amantunes/KNoT/results/pdf/14bits.pdf

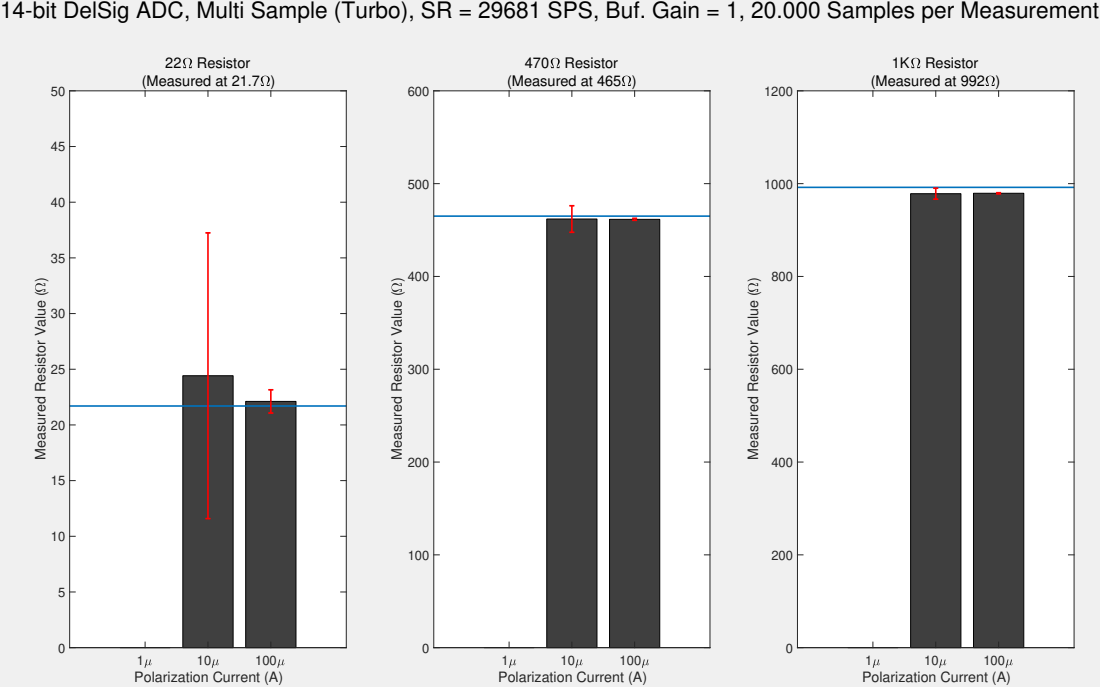
[picture p2: page 1]
22 Resistor (Measured at 21.7 ); Polarization Current (A); 470 Resistor (Measured at 465 ); 1K Resistor (Measured at 992 )

14-bit DelSig ADC, Multi Sample (Turbo), SR = 29681 SPS, Buf. Gain = 1, 20.000 Samples per Measurement

Measured Resistor Value ( )

99.7% Noise = 384.9061 V, RMS Noise = 64.151 V (1.0264 LSB) Pol. Current = 10 A , Resistor Value = 22

0 | 62 | 125 | 187 | 250 | 312 | 375 | 437 | 500 | 562
Measured Voltage ( V)

1000

2000

3000

4000

5000

6000

7000

8000

Number of Samples

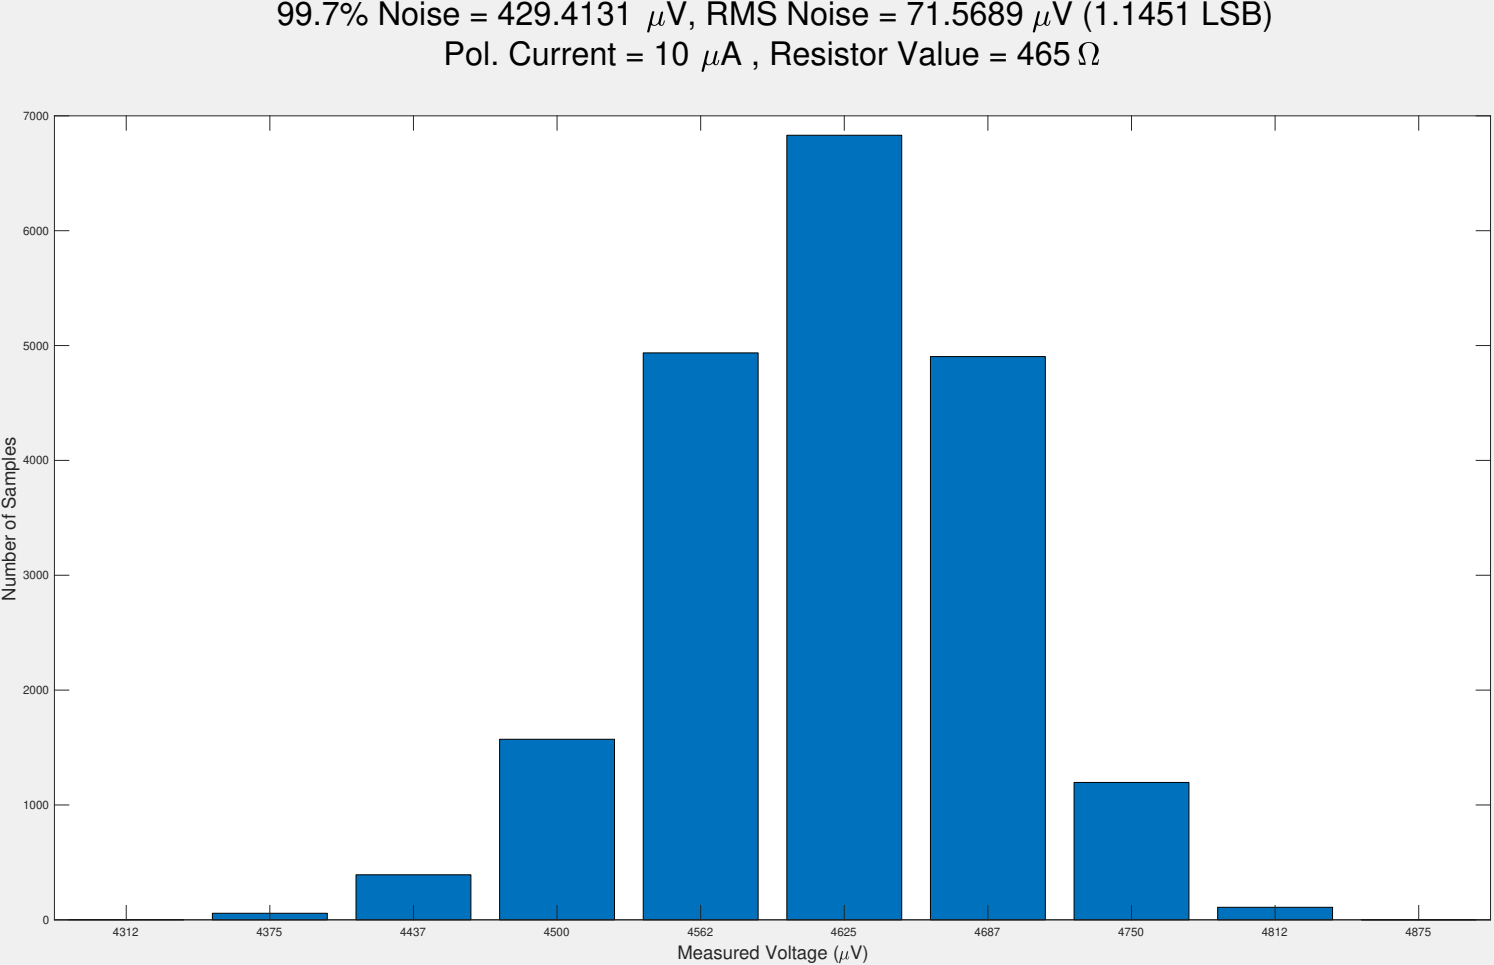
[picture p3: page 3]

99.7% Noise = 429.4131 V, RMS Noise = 71.5689 V (1.1451 LSB)

Number of Samples

99.7% Noise = 354.8669 V, RMS Noise = 59.1445 V (0.94631 LSB)

9500 | 9562 | 9625 | 9687 | 9750 | 9812 | 9875 | 9937 | 10000

1000

2000

3000

4000

5000

6000

7000

8000

9000

Number of Samples

99.7% Noise = 313.4129 V, RMS Noise = 52.2355 V (0.83577 LSB) Pol. Current = 100 A , Resistor Value = 22

2063 | 2125 | 2188 | 2250 | 2313 | 2375 | 2438

1000

2000

3000

4000

5000

6000

7000

8000

9000

Number of Samples

99.7% Noise = 318.9523 V, RMS Noise = 53.1587 V (0.85054 LSB)

45938 | 46000 | 46063 | 46125 | 46188 | 46250 | 46313 | 46375

1000

2000

3000

4000

5000

6000

7000

8000

9000

Number of Samples

99.7% Noise = 365.5644 V, RMS Noise = 60.9274 V (0.97484 LSB)

97688 | 97750 | 97813 | 97875 | 97938 | 98000 | 98063 | 98125 | 98188

1000

2000

3000

4000

5000

6000

7000

8000

9000

Number of Samples
