amantunes/KNoT/schematic/iot_sensor_node_schematic.pdf

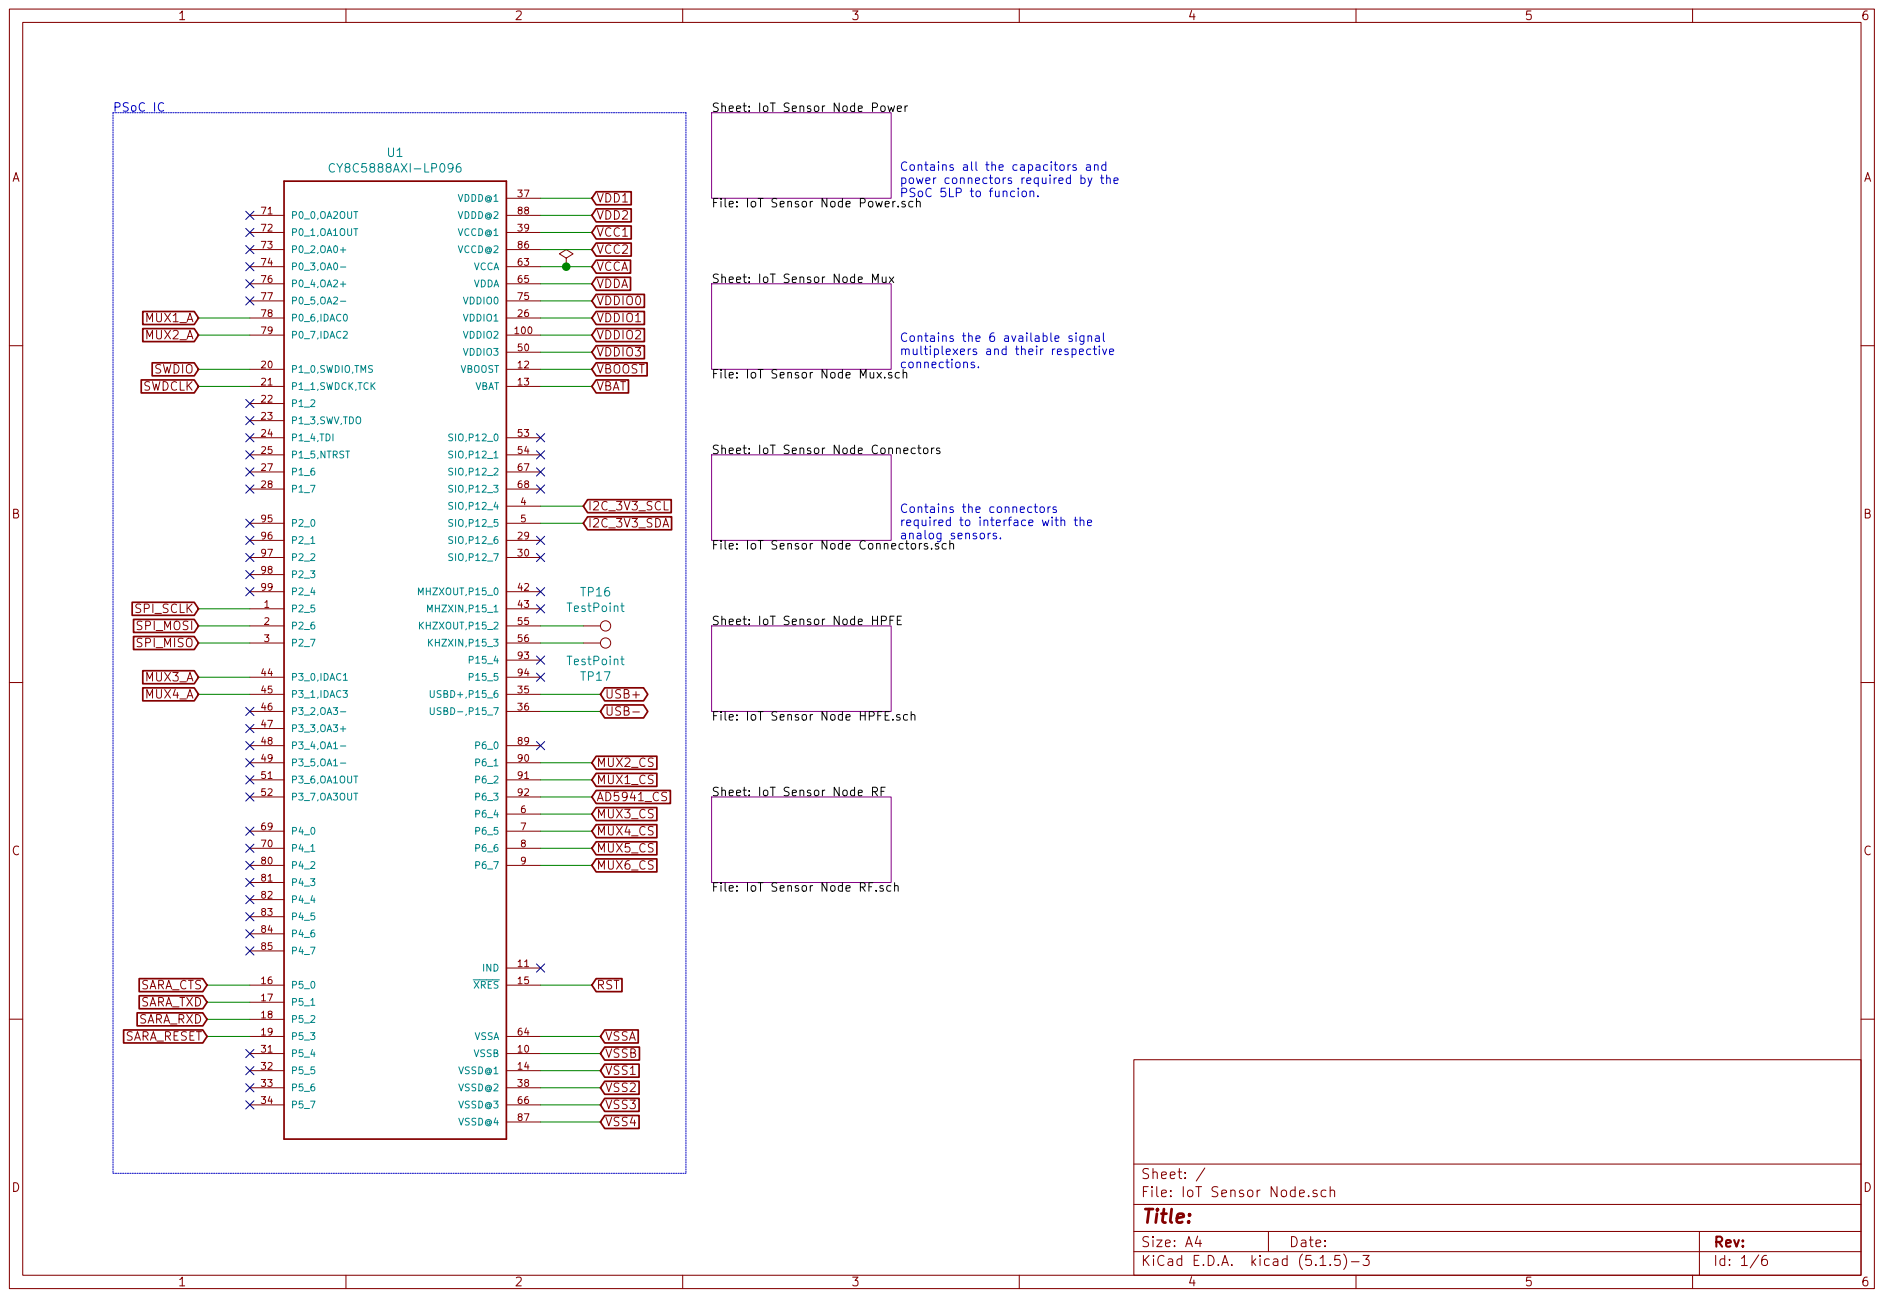
[picture p4: page 1]

File: IoT Sensor Node RF.sch Sheet: IoT Sensor Node Connectors File: IoT Sensor Node Connectors.sch Sheet: IoT Sensor Node Mux File: IoT Sensor Node Mux.sch Sheet: IoT Sensor Node Power File: IoT Sensor Node Power.sch TP17 TestPoint TP16
SARA_RESET SARA_CTS MUX1_A
I2C_3V3_SCL VDDIO2 VDDIO3 MUX3_A MUX4_A

analog sensors. PSoC IC

Contains all the capacitors and
power connectors required by the PSoC 5LP to funcion. Contains the 6 available signal

multiplexers and their respective
connections. Contains the connectors required to interface with the

Sheet: IoT Sensor Node HPFE

File: IoT Sensor Node HPFE.sch Sheet: IoT Sensor Node RF

Id: 1/6 Title: File: IoT Sensor Node.sch Sheet: /

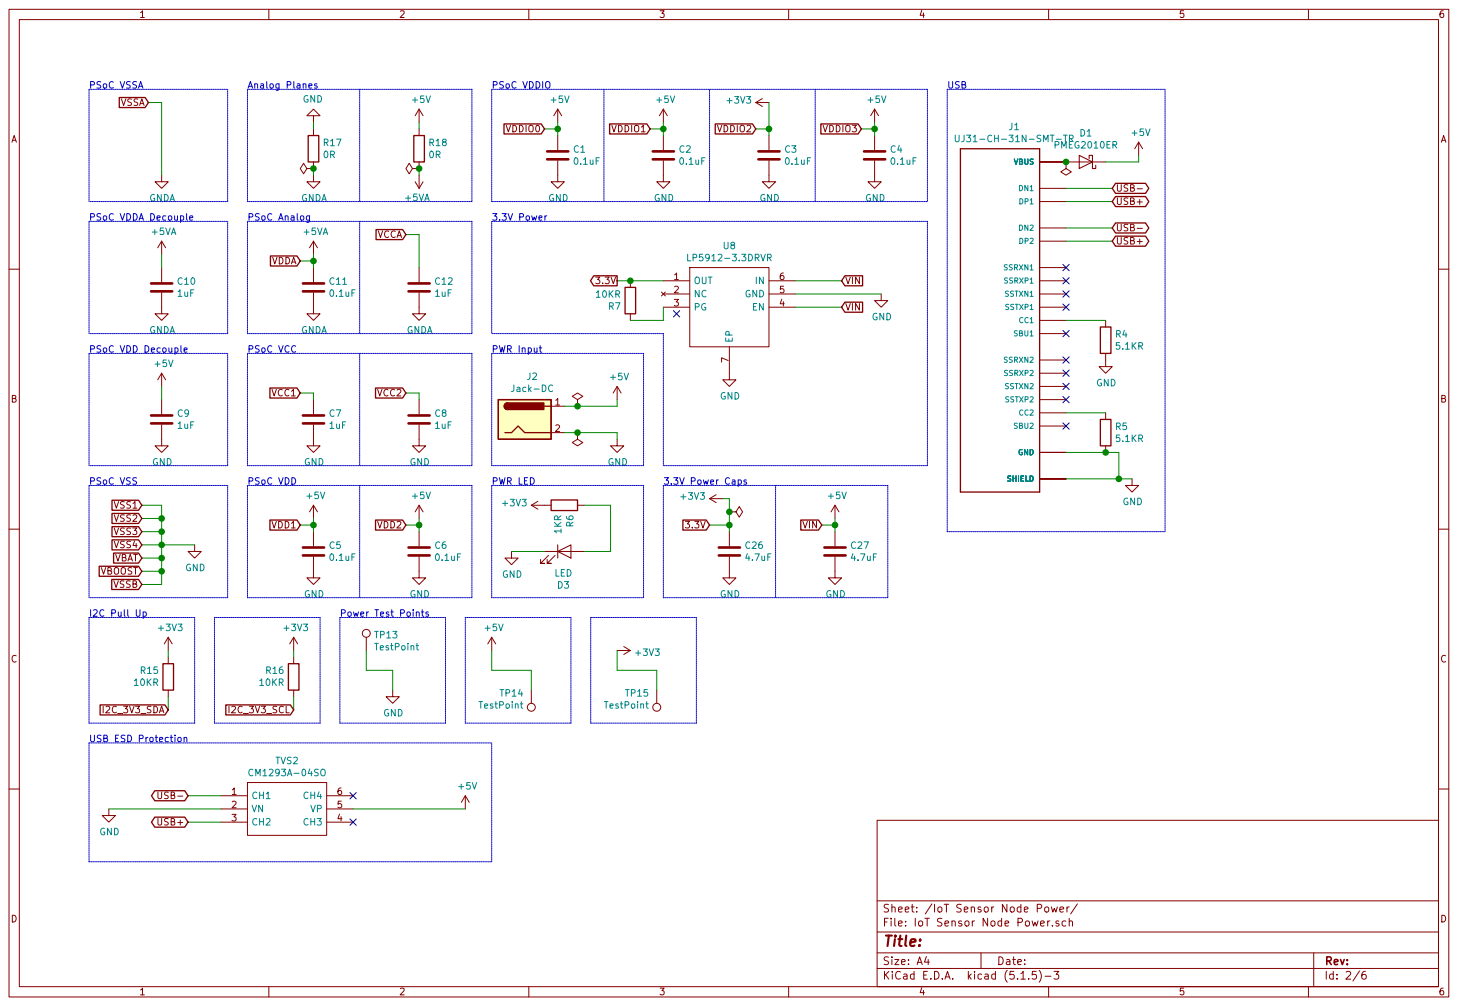
[picture p5: page 2]

PWR Input Power Test Points PSoC VDD Decouple

Id: 2/6 Title: File: IoT Sensor Node Power.sch Sheet: /IoT Sensor Node Power/

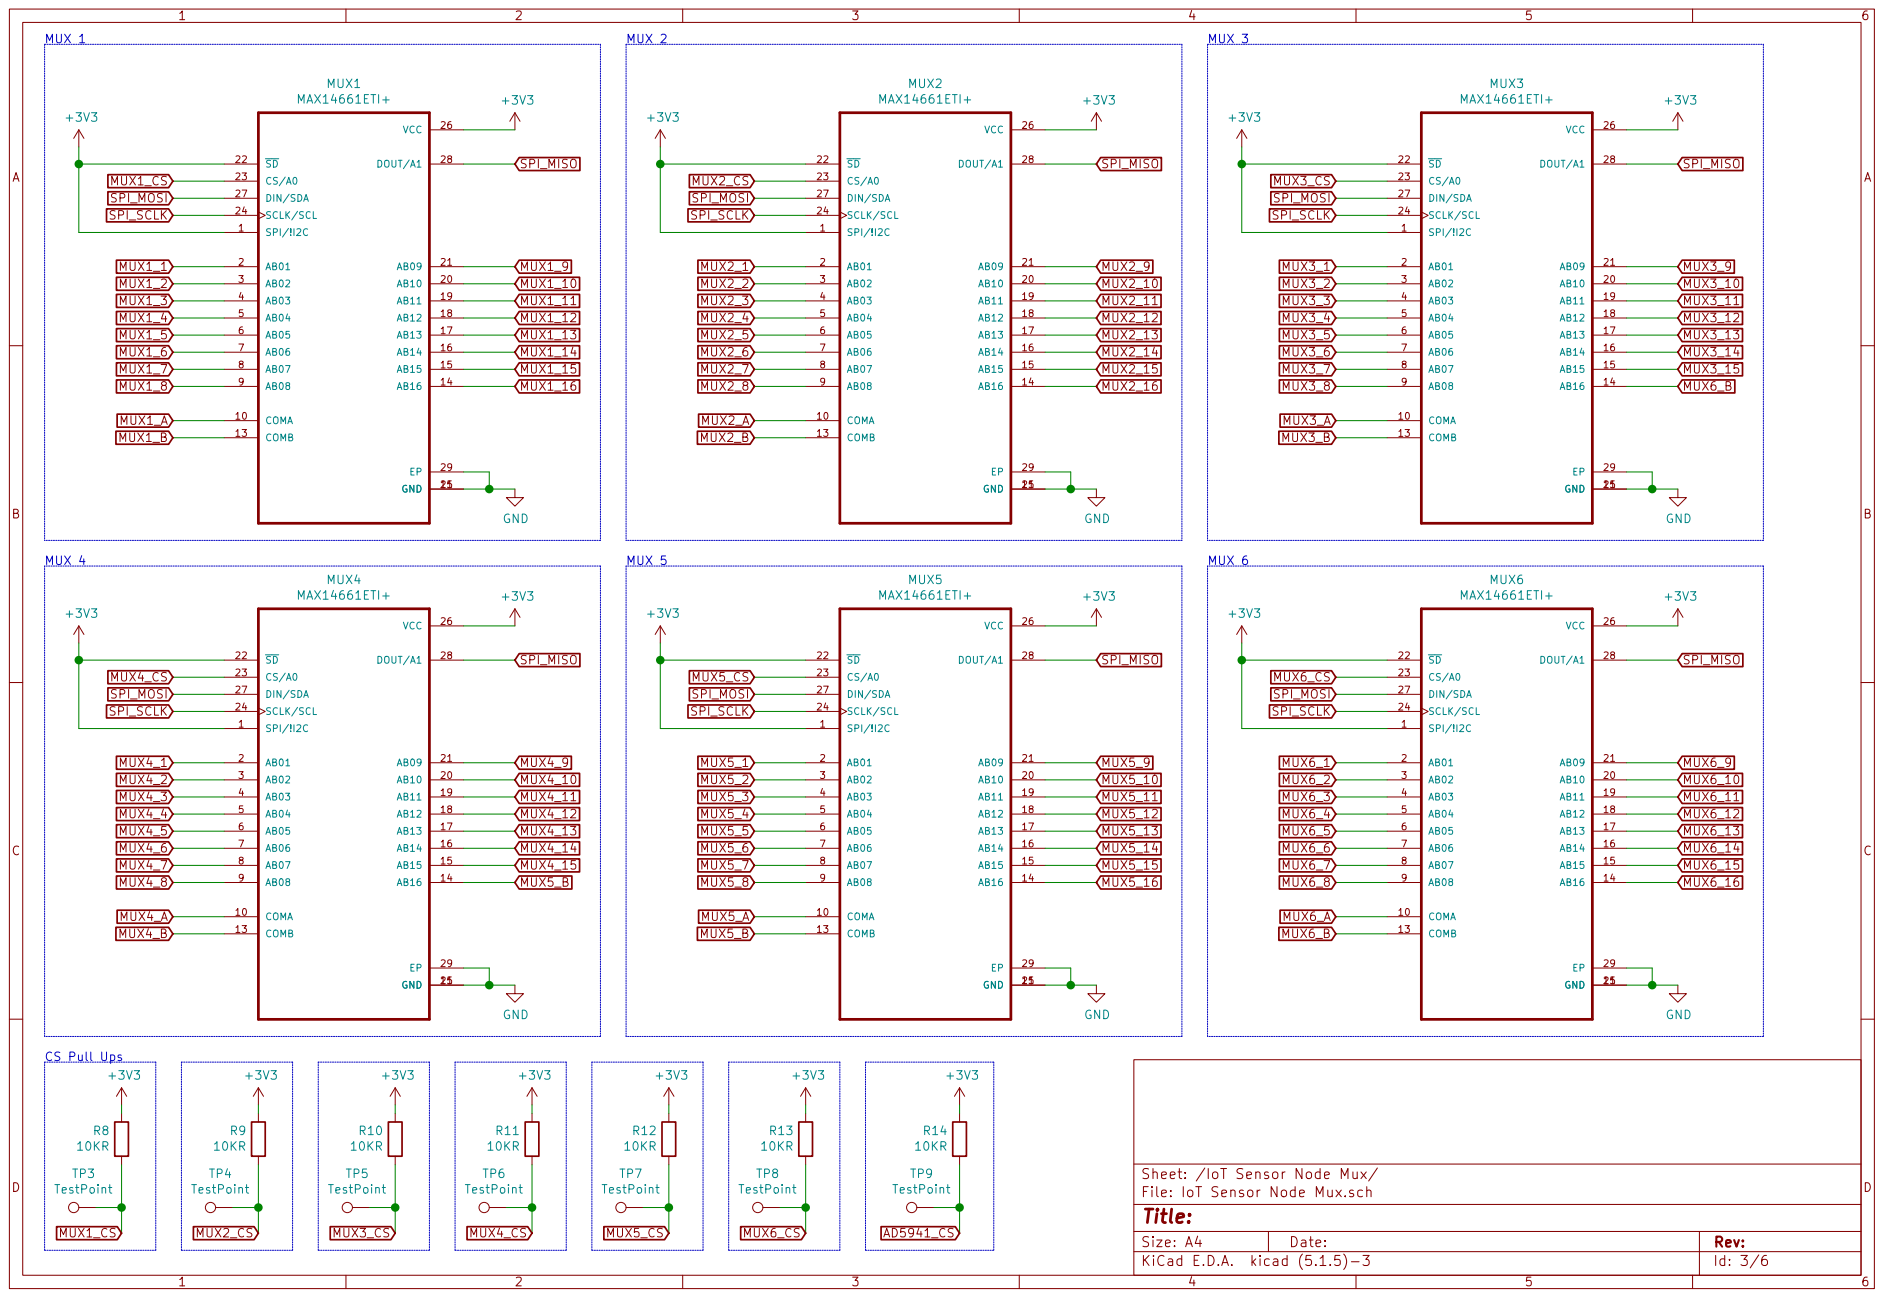
[picture p6: page 3]

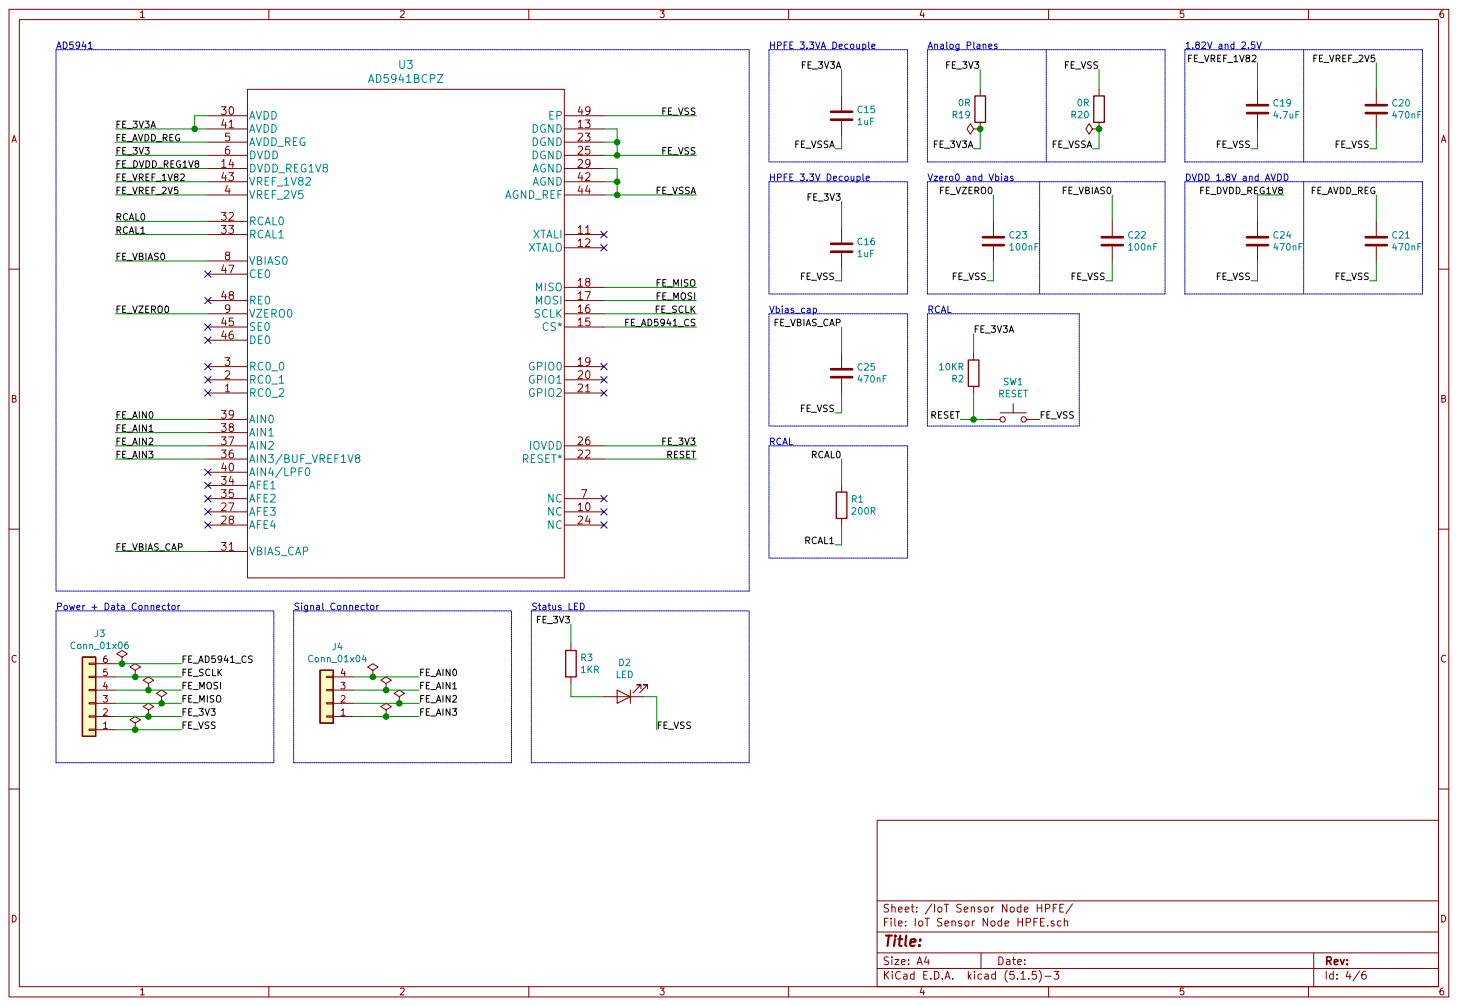
[picture p7: page 4]

Id: 4/6 Title: File: IoT Sensor Node HPFE.sch Sheet: /IoT Sensor Node HPFE/

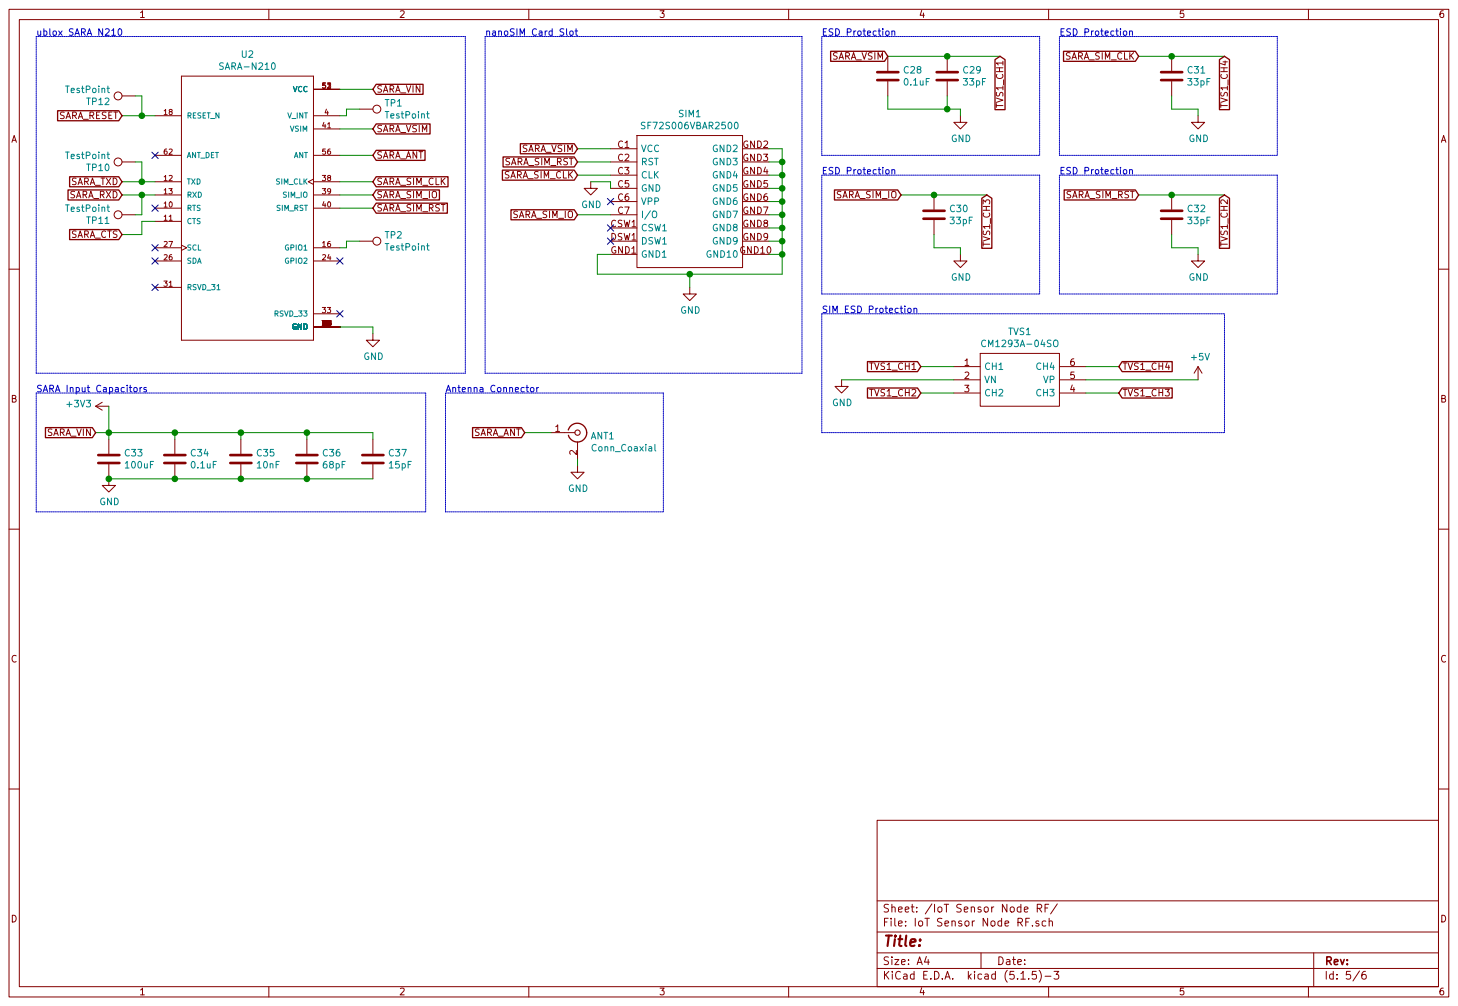
[picture p8: page 5]

Id: 5/6 Title: File: IoT Sensor Node RF.sch Sheet: /IoT Sensor Node RF/

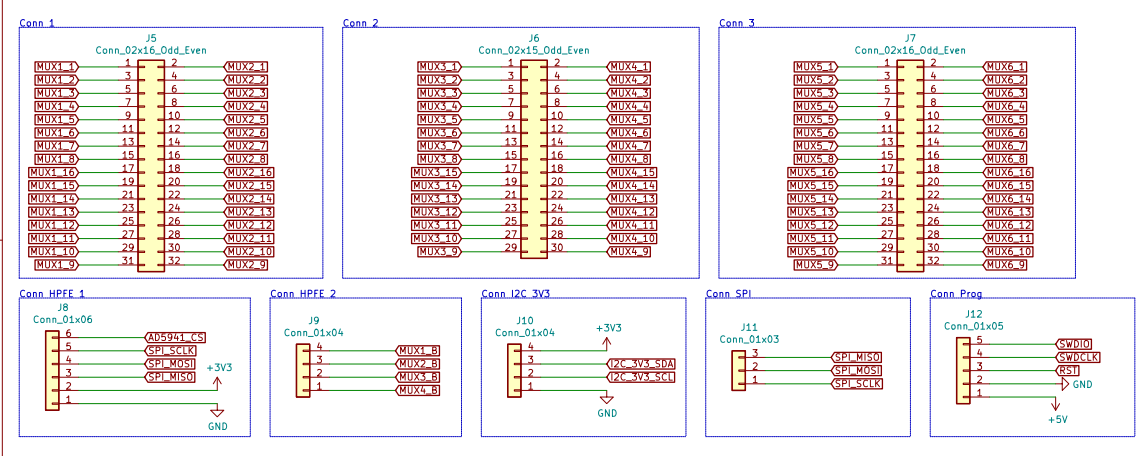
[picture p9: page 6]

Id: 6/6 Title: File: IoT Sensor Node Connectors.sch Sheet: /IoT Sensor Node Connectors/
