amantunes/KNoT/results/pdf/16bits.pdf

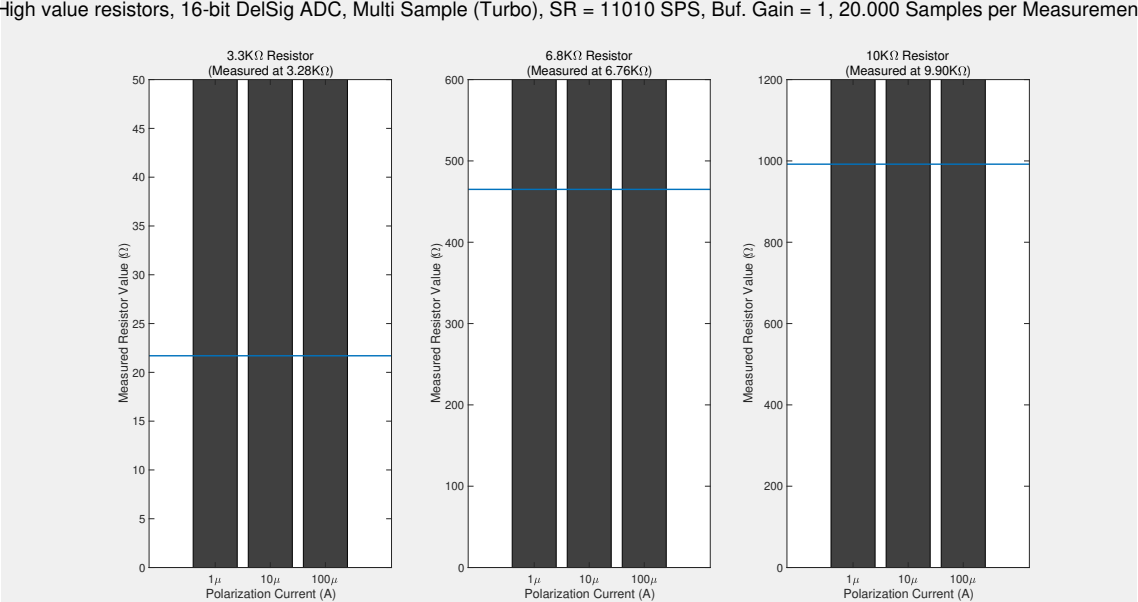
[picture p10: page 1]
3.3K Resistor (Measured at 3.28K ); Polarization Current (A); 6.8K Resistor (Measured at 6.76K ); 10K Resistor (Measured at 9.90K )

High value resistors, 16-bit DelSig ADC, Multi Sample (Turbo), SR = 11010 SPS, Buf. Gain = 1, 20.000 Samples per Measurement

Measured Resistor Value ( )

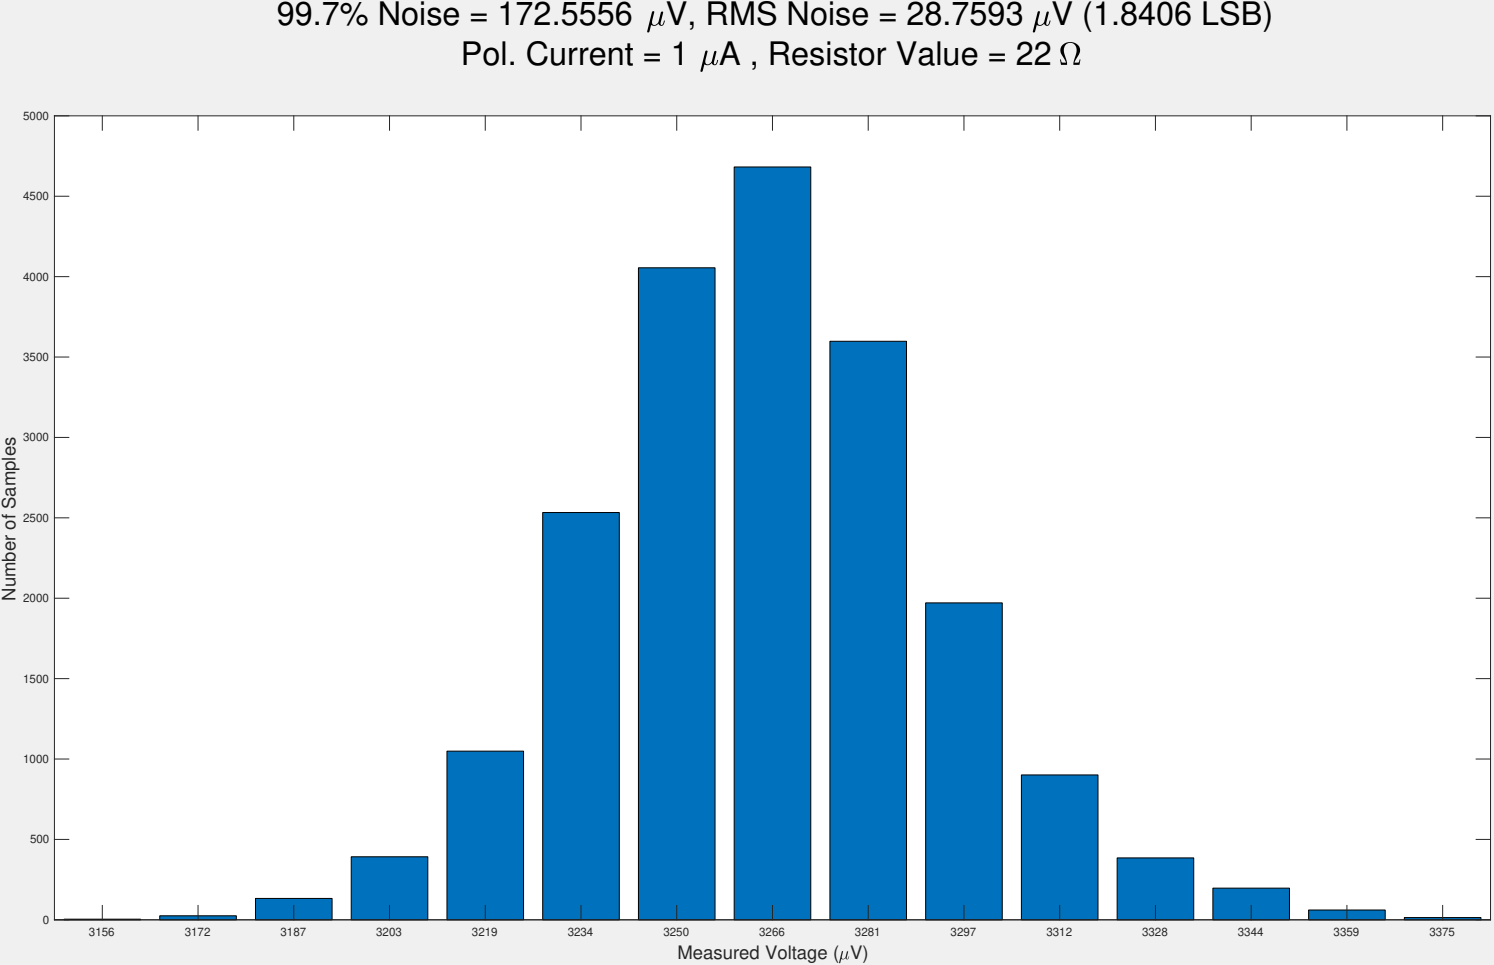
[picture p11: page 2]
Measured Voltage ( V)

99.7% Noise = 172.5556 V, RMS Noise = 28.7593 V (1.8406 LSB)

Pol. Current = 1 A , Resistor Value = 22

Number of Samples

99.7% Noise = 181.9757 V, RMS Noise = 30.3293 V (1.9411 LSB) Pol. Current = 1 A , Resistor Value = 465

6516 | 6531 | 6547 | 6562 | 6578 | 6594 | 6609 | 6625 | 6641 | 6656 | 6672 | 6687 | 6703 | 6719 | 6734 | 6750 | 6766

500

1000

1500

2000

2500

3000

3500

4000

4500

Number of Samples

99.7% Noise = 204.0454 V, RMS Noise = 34.0076 V (2.1765 LSB) Pol. Current = 1 A , Resistor Value = 992

9594 | 9609 | 9625 | 9641 | 9656 | 9672 | 9687 | 9703 | 9719 | 9734 | 9750 | 9766 | 9781 | 9797 | 9812 | 9828 | 9844

500

1000

1500

2000

2500

3000

3500

4000

Number of Samples

99.7% Noise = 169.8142 V, RMS Noise = 28.3024 V (1.8114 LSB) Pol. Current = 10 A , Resistor Value = 22

32750 | 32766 | 32782 | 32797 | 32813 | 32828 | 32844 | 32860 | 32875 | 32891 | 32907 | 32922 | 32938 | 32953 | 32969 | 32985

500

1000

1500

2000

2500

3000

3500

4000

4500

5000

Number of Samples

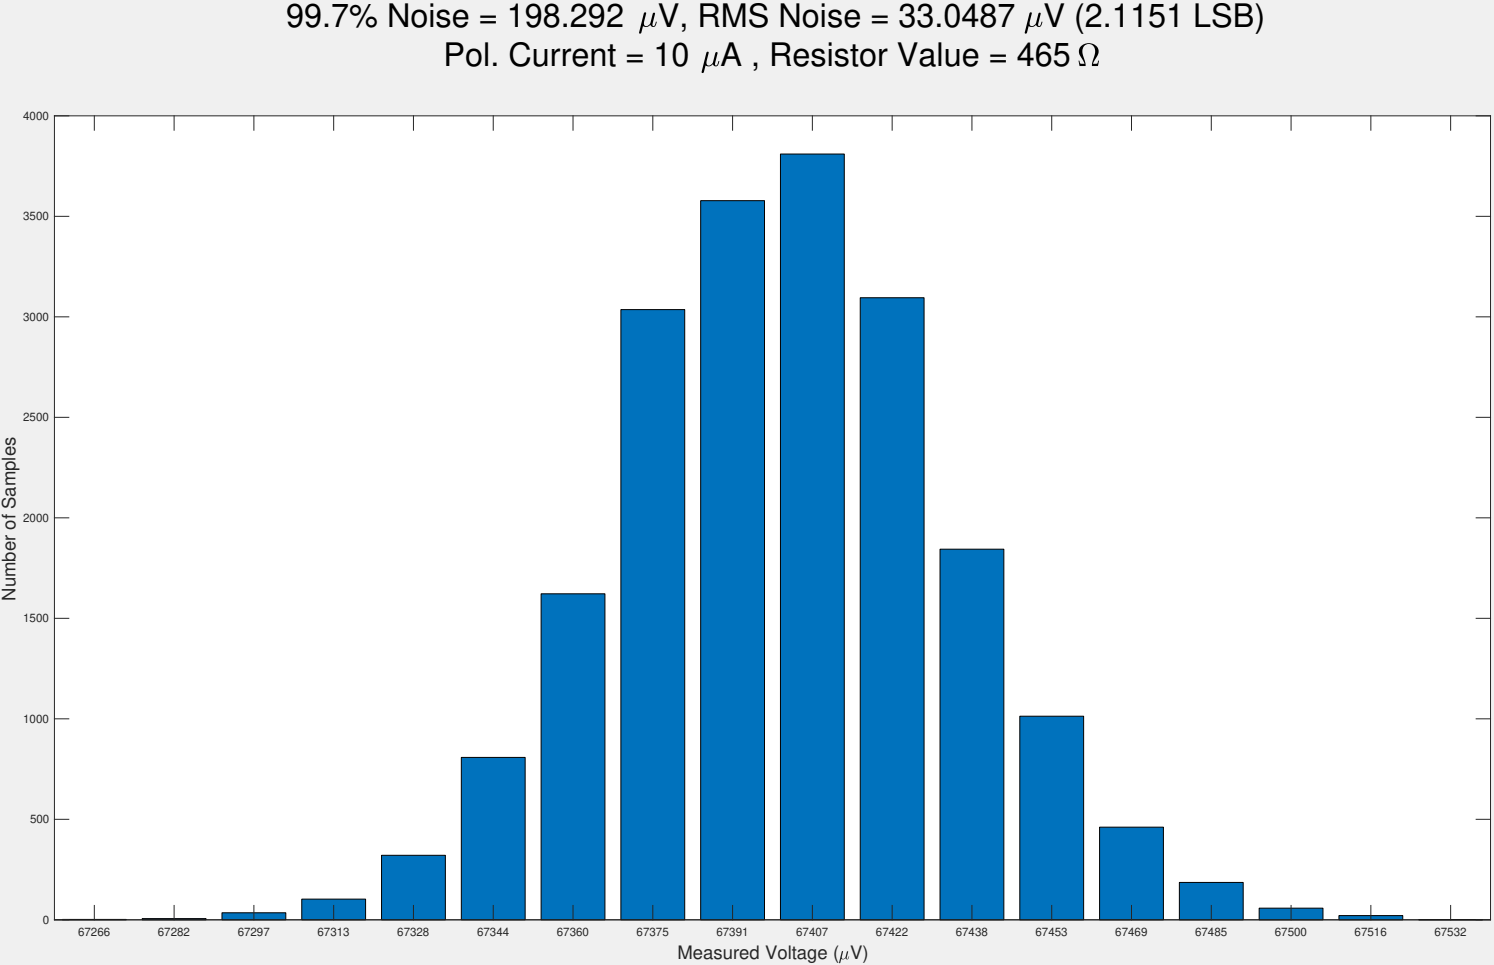
[picture p12: page 6]

99.7% Noise = 198.292 V, RMS Noise = 33.0487 V (2.1151 LSB)

Pol. Current = 10 A , Resistor Value = 465

Number of Samples
