amantunes/KNoT/results/pdf/18bits.pdf

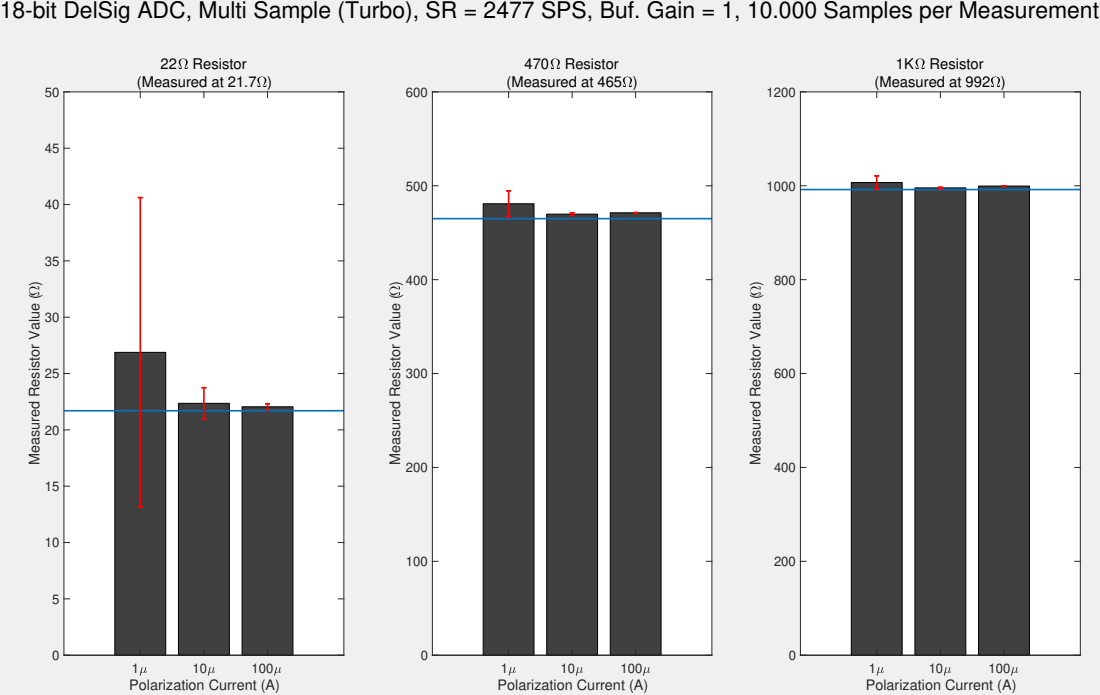
[picture p13: page 1]
22 Resistor (Measured at 21.7 ); Polarization Current (A); 470 Resistor (Measured at 465 ); 1K Resistor (Measured at 992 )

18-bit DelSig ADC, Multi Sample (Turbo), SR = 2477 SPS, Buf. Gain = 1, 10.000 Samples per Measurement

Measured Resistor Value ( )

99.7% Noise = 41.2071 V, RMS Noise = 6.8679 V (1.7582 LSB) Pol. Current = 1 A , Resistor Value = 22

0 | 4 | 8 | 12 | 15 | 19 | 23 | 27 | 31 | 35 | 39 | 43 | 47 | 51 | 54
Measured Voltage ( V)

0

500

1000

1500

2000

2500

Number of Samples

99.7% Noise = 41.3857 V, RMS Noise = 6.8976 V (1.7658 LSB) Pol. Current = 1 A , Resistor Value = 465

453 | 461 | 465 | 469 | 472 | 476 | 480 | 484 | 488 | 492 | 496 | 500 | 504 | 508 | 512

500

1000

1500

2000

2500

Number of Samples

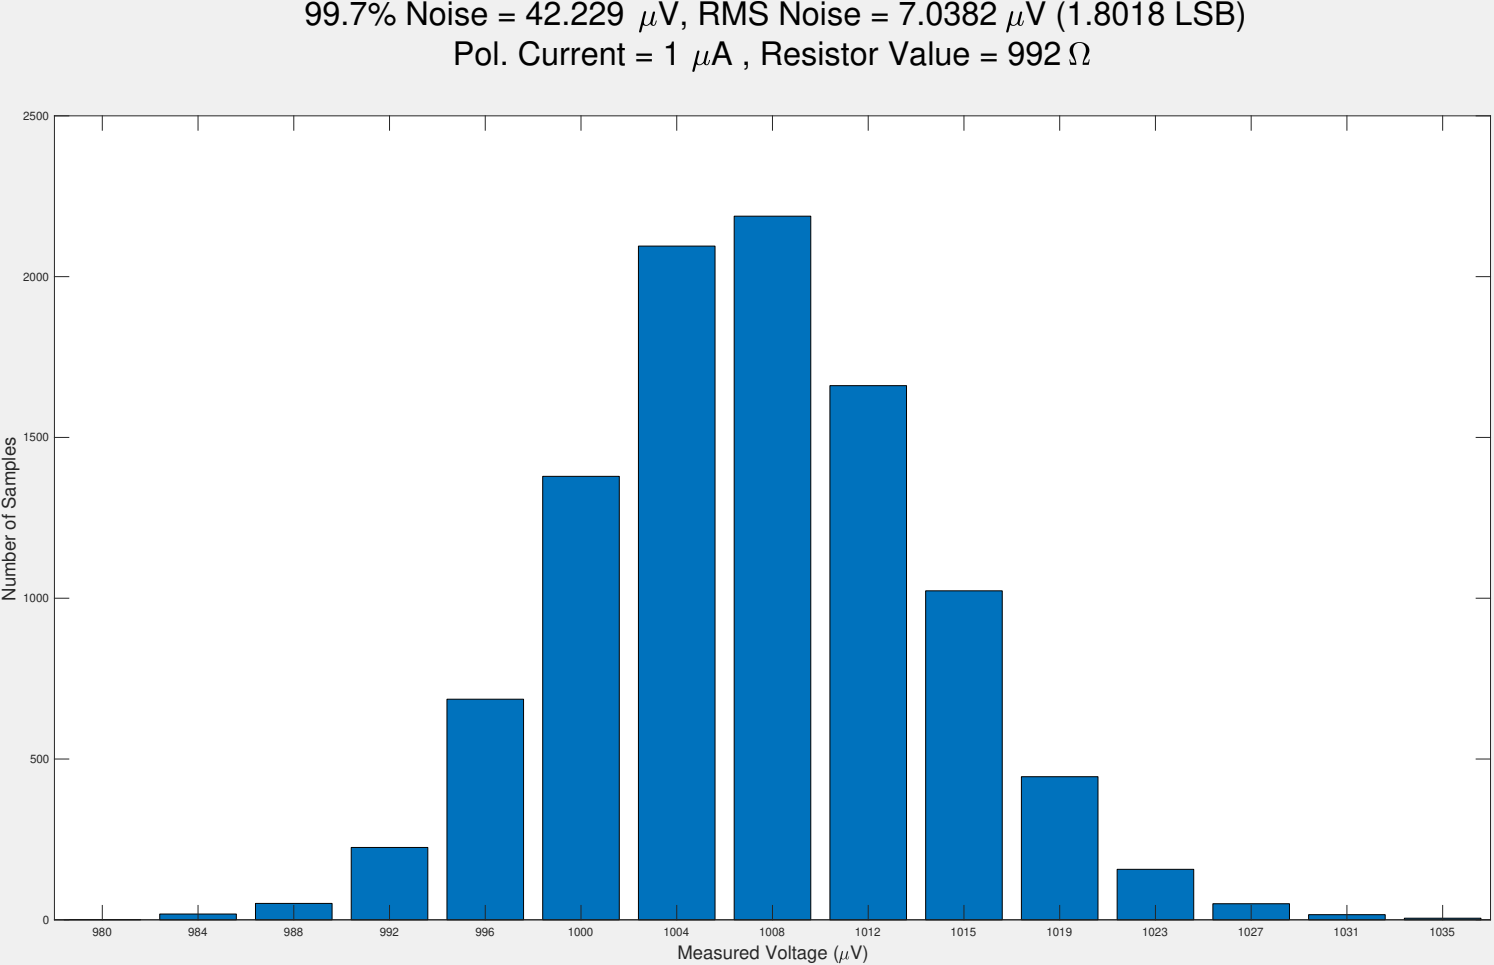
[picture p14: page 4]

99.7% Noise = 42.229 V, RMS Noise = 7.0382 V (1.8018 LSB)

Pol. Current = 1 A , Resistor Value = 992

Number of Samples

99.7% Noise = 41.5204 V, RMS Noise = 6.9201 V (1.7715 LSB) Pol. Current = 10 A , Resistor Value = 22

199 | 203 | 207 | 210 | 214 | 218 | 222 | 226 | 230 | 234 | 238 | 242 | 246 | 250

500

1000

1500

2000

2500

Number of Samples

99.7% Noise = 43.0999 V, RMS Noise = 7.1833 V (1.8389 LSB) Pol. Current = 10 A , Resistor Value = 465

4675 | 4679 | 4683 | 4687 | 4691 | 4695 | 4699 | 4703 | 4707 | 4710 | 4714 | 4718 | 4722 | 4726 | 4734

500

1000

1500

2000

2500

Number of Samples

99.7% Noise = 43.2501 V, RMS Noise = 7.2083 V (1.8453 LSB) Pol. Current = 10 A , Resistor Value = 992

9929 | 9933 | 9937 | 9941 | 9945 | 9949 | 9953 | 9957 | 9960 | 9964 | 9968 | 9972 | 9976 | 9980

500

1000

1500

2000

2500

Number of Samples

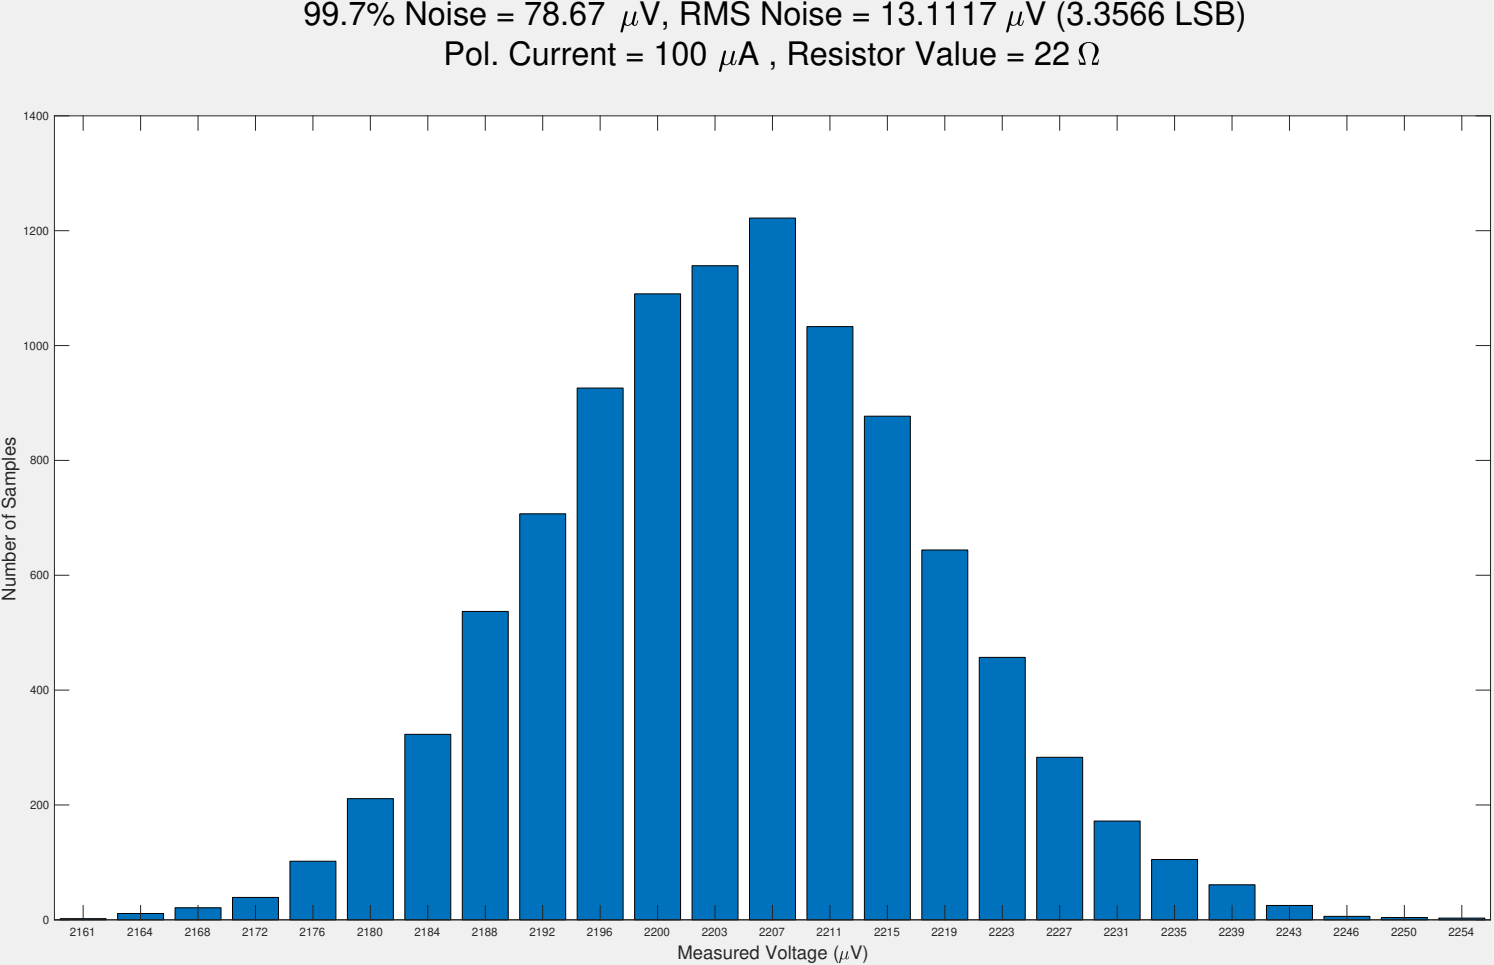
[picture p15: page 8]

99.7% Noise = 78.67 V, RMS Noise = 13.1117 V (3.3566 LSB)

Pol. Current = 100 A , Resistor Value = 22

Number of Samples

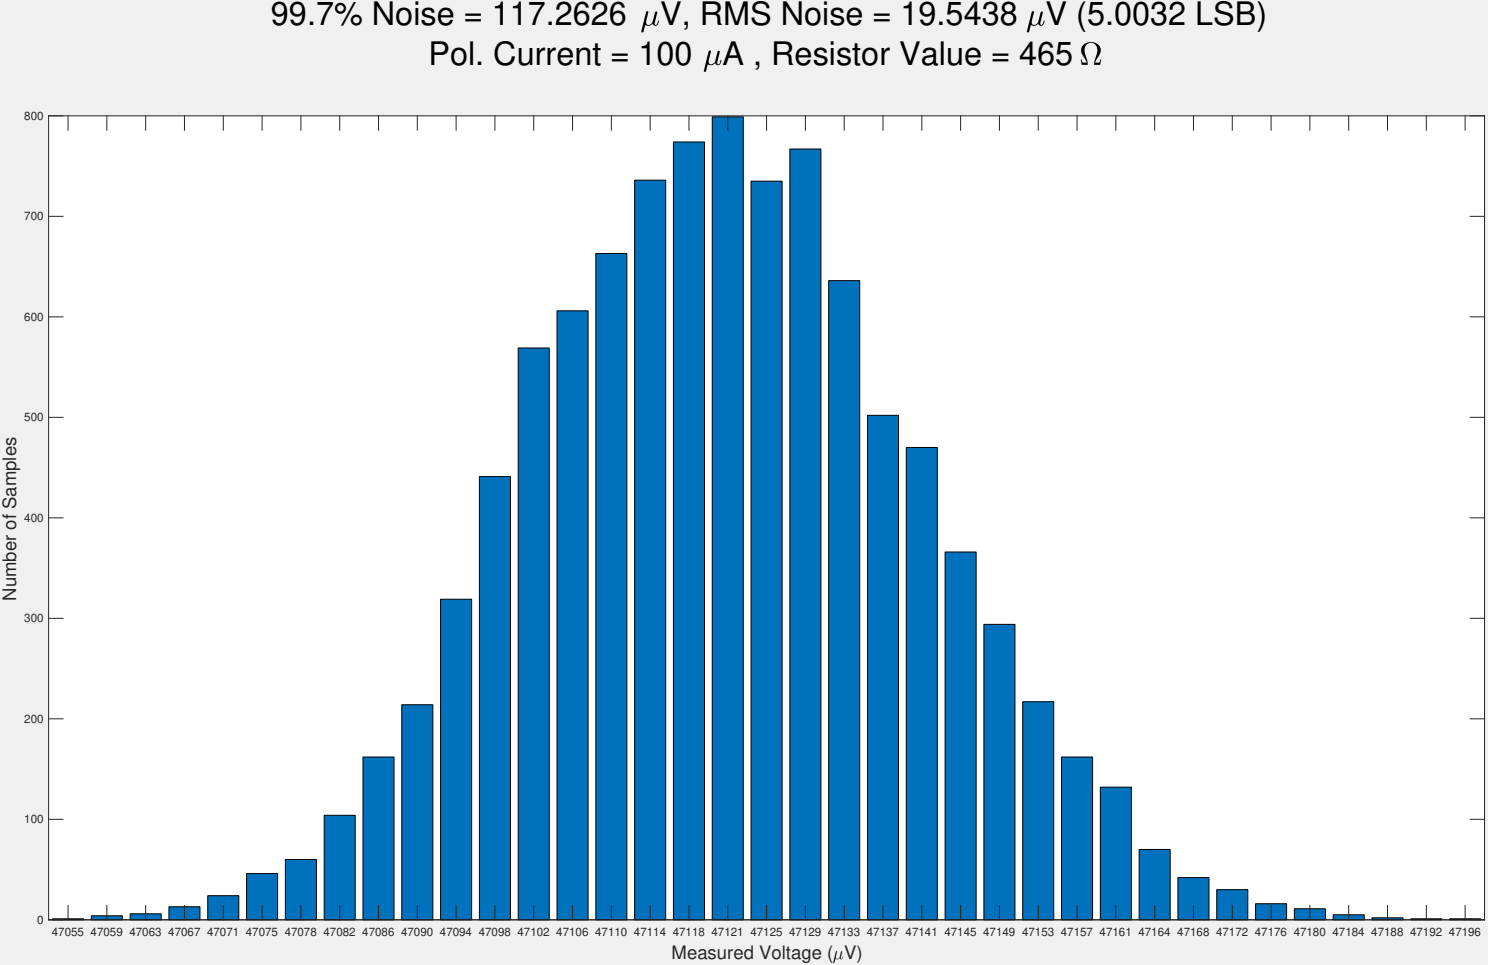
[picture p16: page 9]

99.7% Noise = 117.2626 V, RMS Noise = 19.5438 V (5.0032 LSB)

Pol. Current = 100 A , Resistor Value = 465

Number of Samples

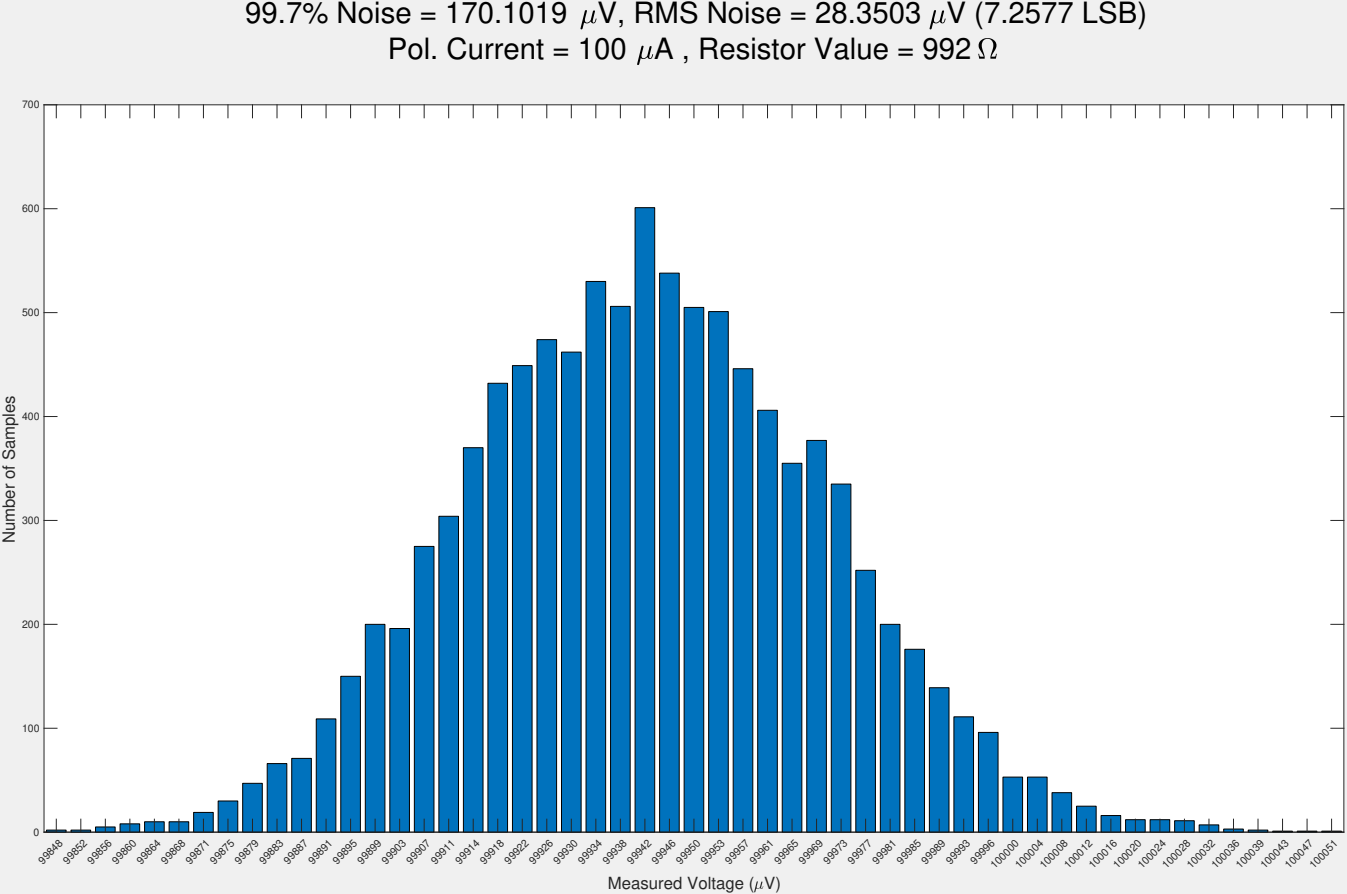
[picture p17: page 10]

99.7% Noise = 170.1019 V, RMS Noise = 28.3503 V (7.2577 LSB)

Pol. Current = 100 A , Resistor Value = 992

Number of Samples
