amantunes/KNoT/results/pdf/20bits.pdf

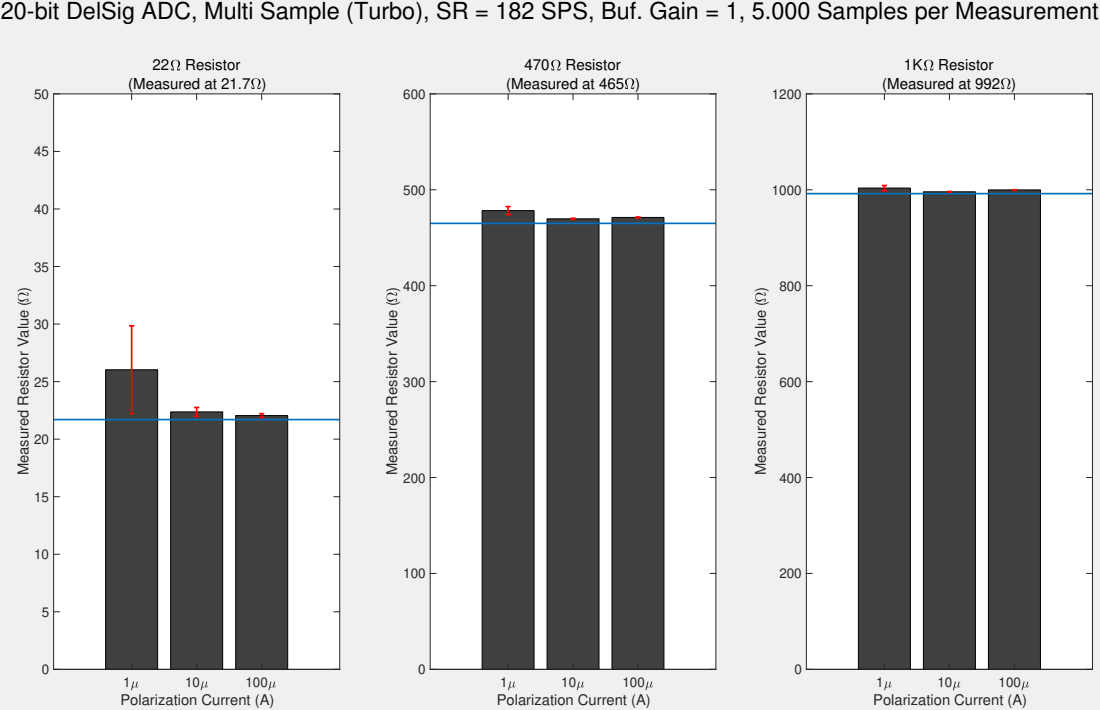
[picture p18: page 1]
22 Resistor (Measured at 21.7 ); Polarization Current (A); 470 Resistor (Measured at 465 ); 1K Resistor (Measured at 992 )

20-bit DelSig ADC, Multi Sample (Turbo), SR = 182 SPS, Buf. Gain = 1, 5.000 Samples per Measurement

Measured Resistor Value ( )

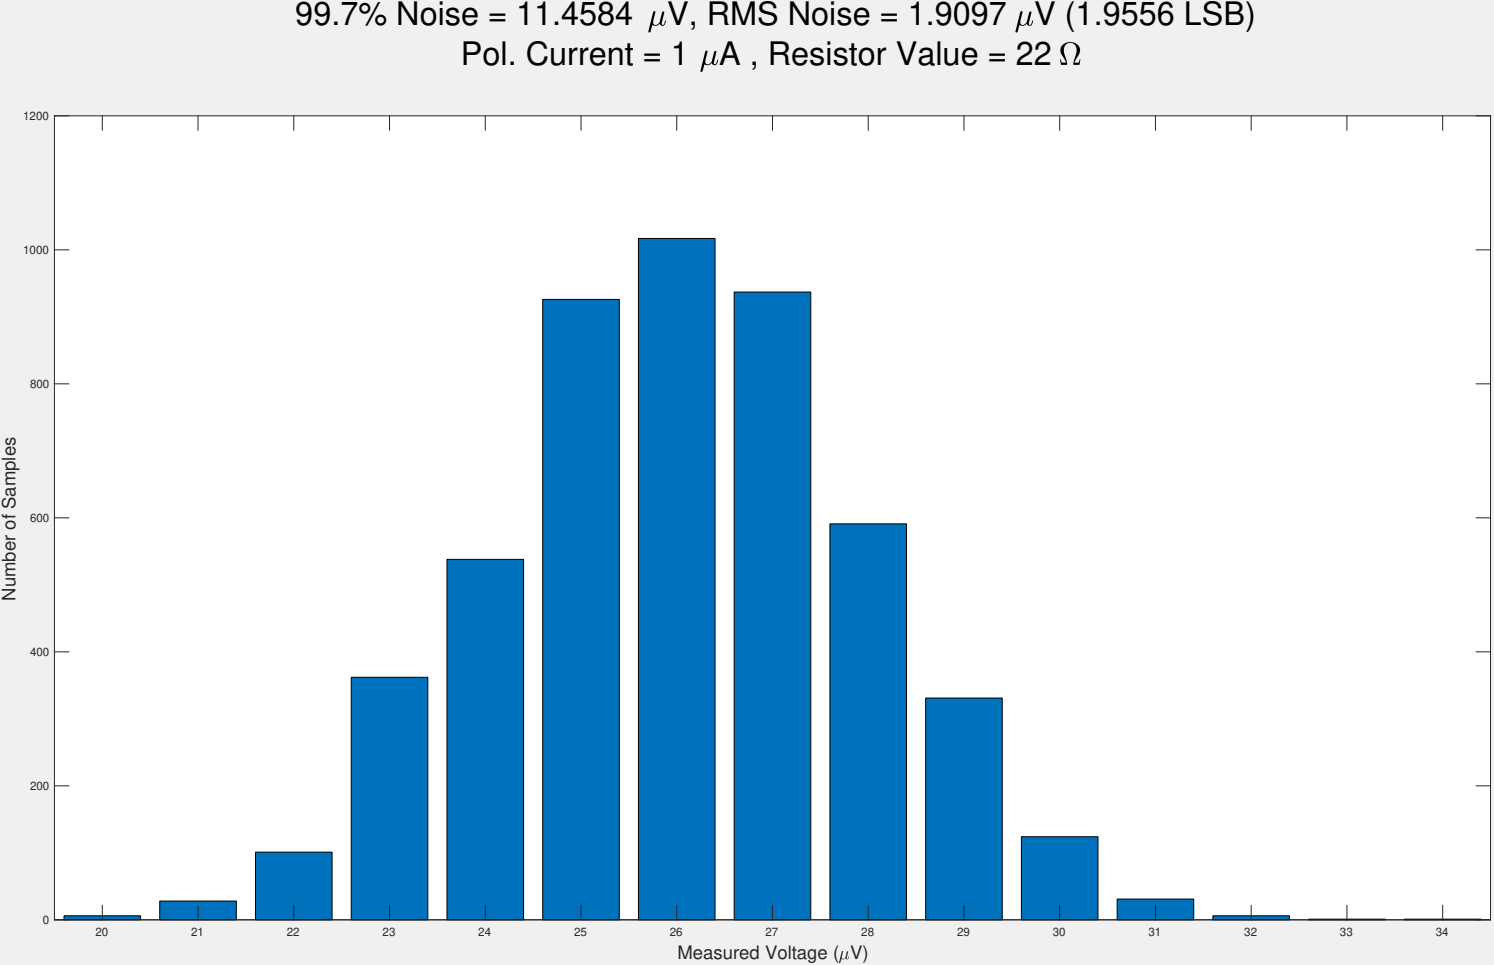
[picture p19: page 2]
Measured Voltage ( V)

99.7% Noise = 11.4584 V, RMS Noise = 1.9097 V (1.9556 LSB)

Pol. Current = 1 A , Resistor Value = 22

Number of Samples

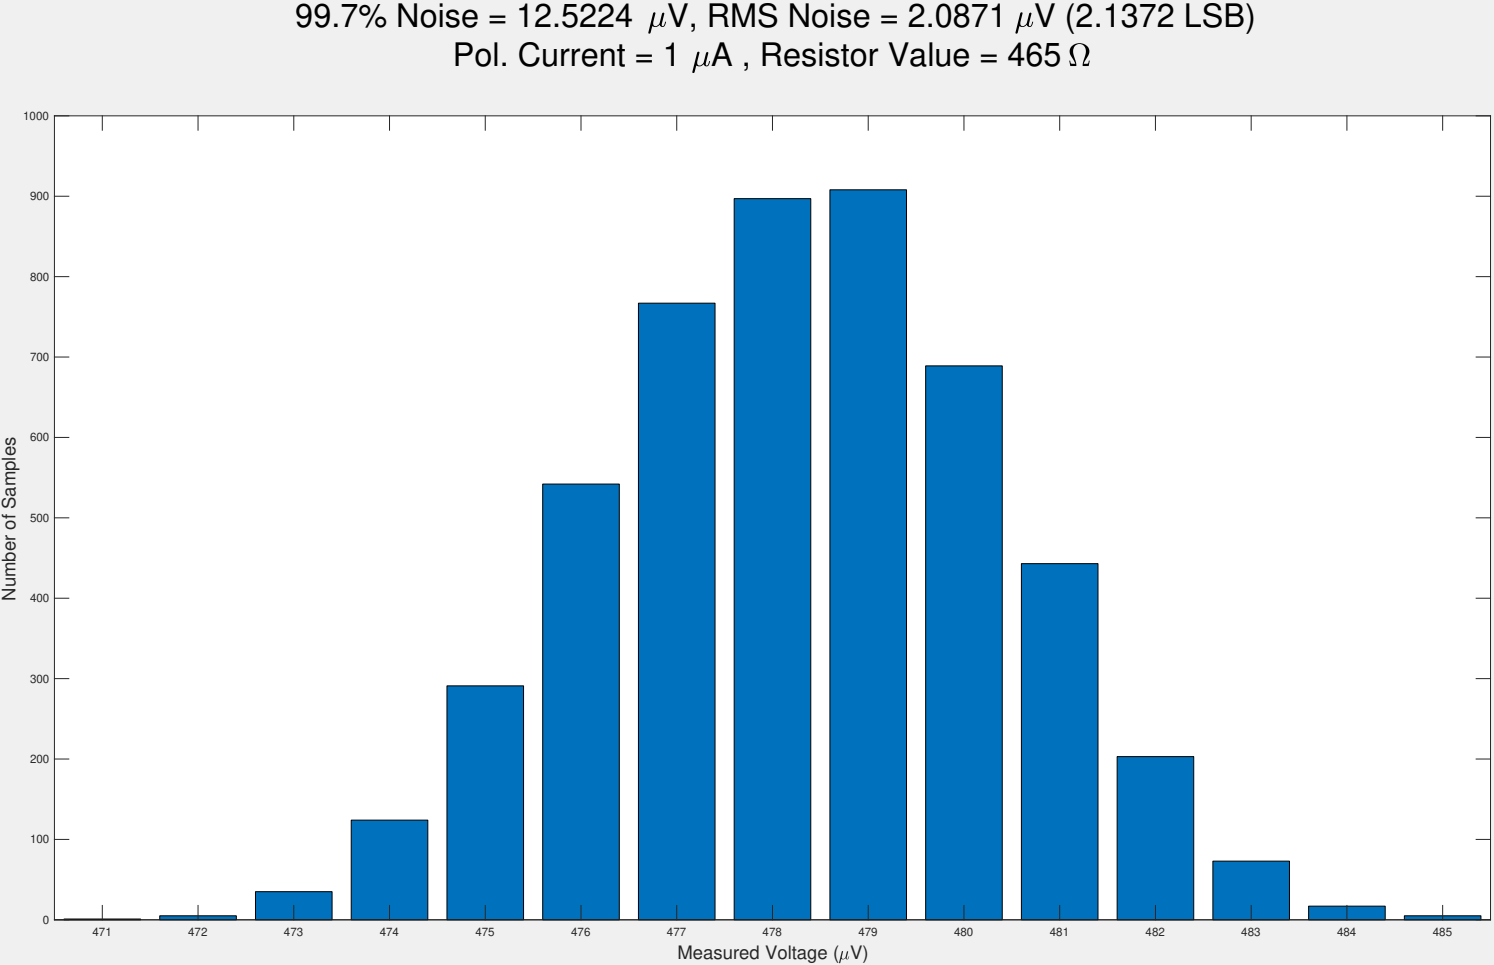
[picture p20: page 3]

99.7% Noise = 12.5224 V, RMS Noise = 2.0871 V (2.1372 LSB)

Pol. Current = 1 A , Resistor Value = 465

Number of Samples

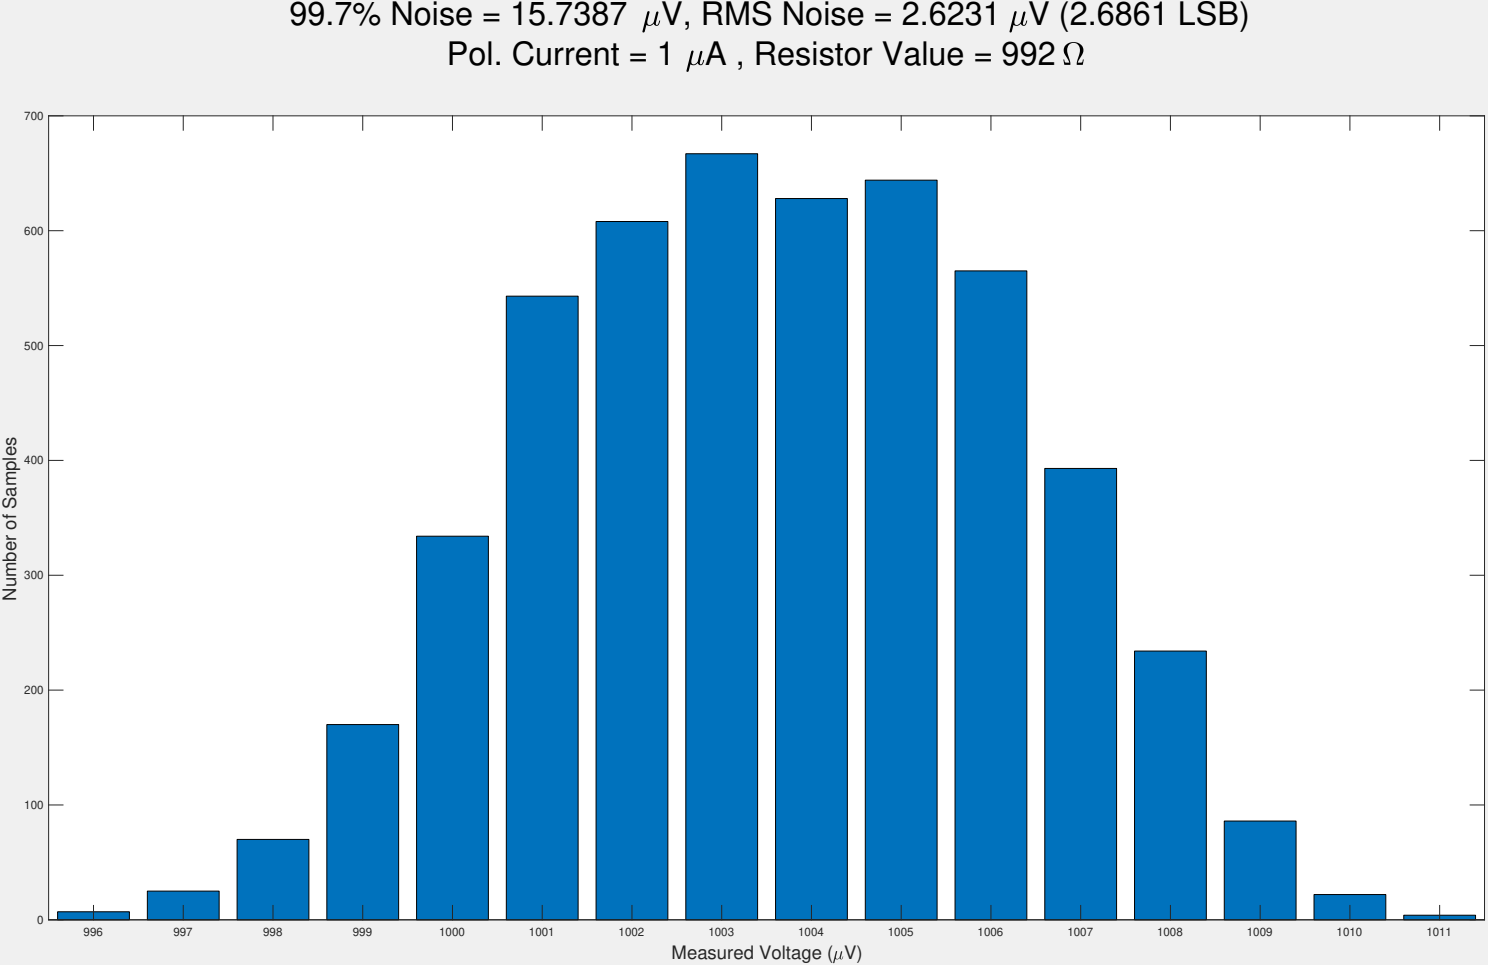
[picture p21: page 4]

99.7% Noise = 15.7387 V, RMS Noise = 2.6231 V (2.6861 LSB)

Pol. Current = 1 A , Resistor Value = 992

Number of Samples

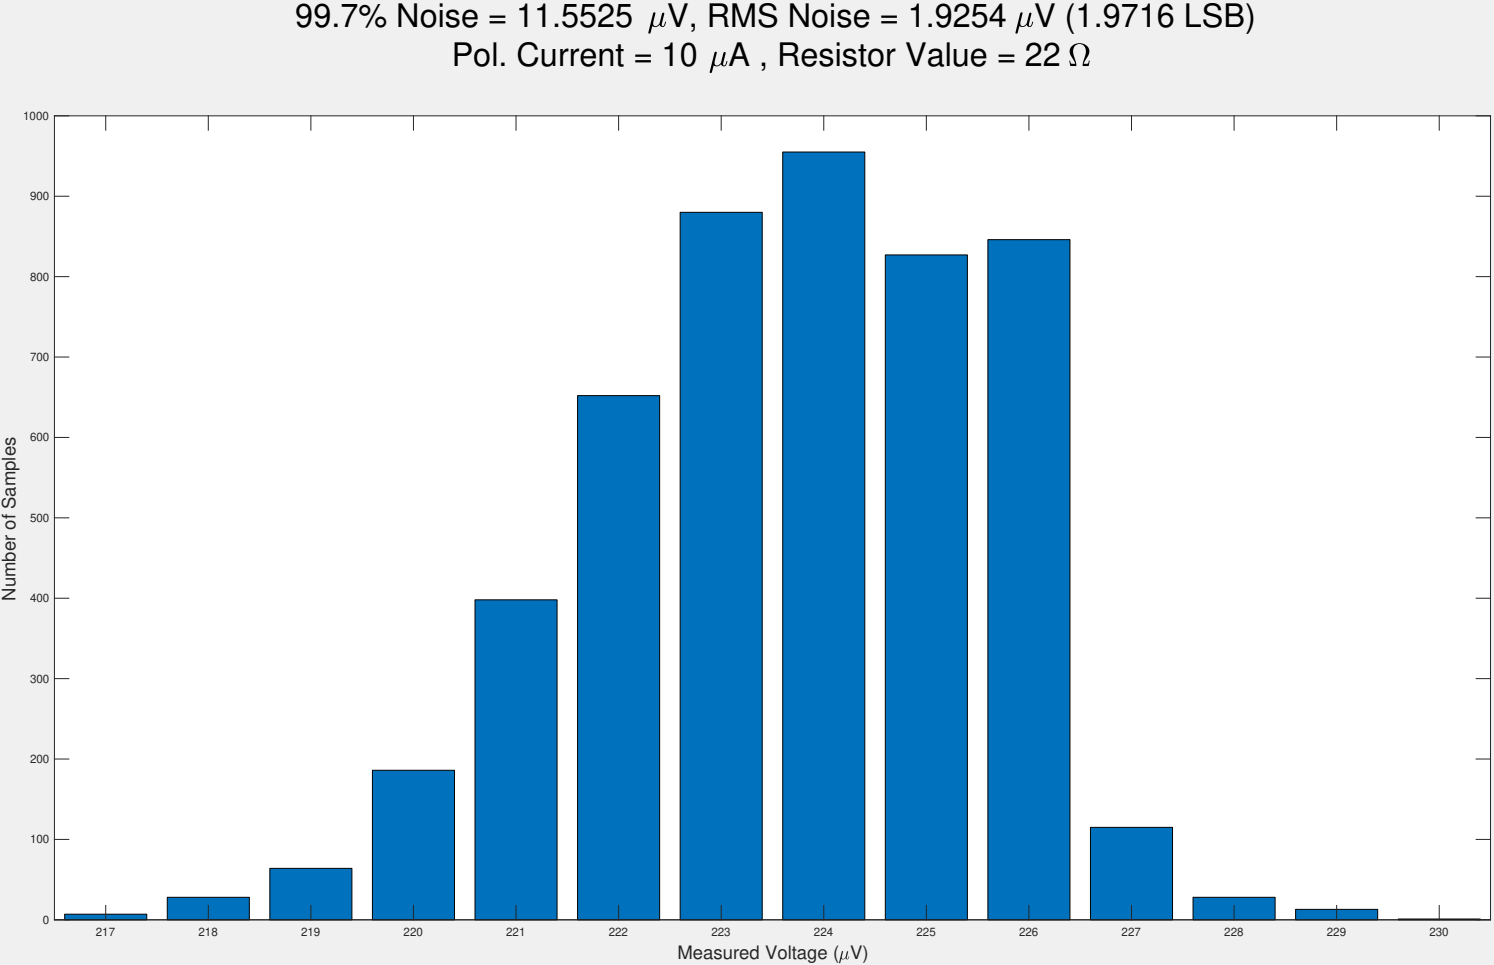
[picture p22: page 5]

99.7% Noise = 11.5525 V, RMS Noise = 1.9254 V (1.9716 LSB)

Pol. Current = 10 A , Resistor Value = 22

Number of Samples

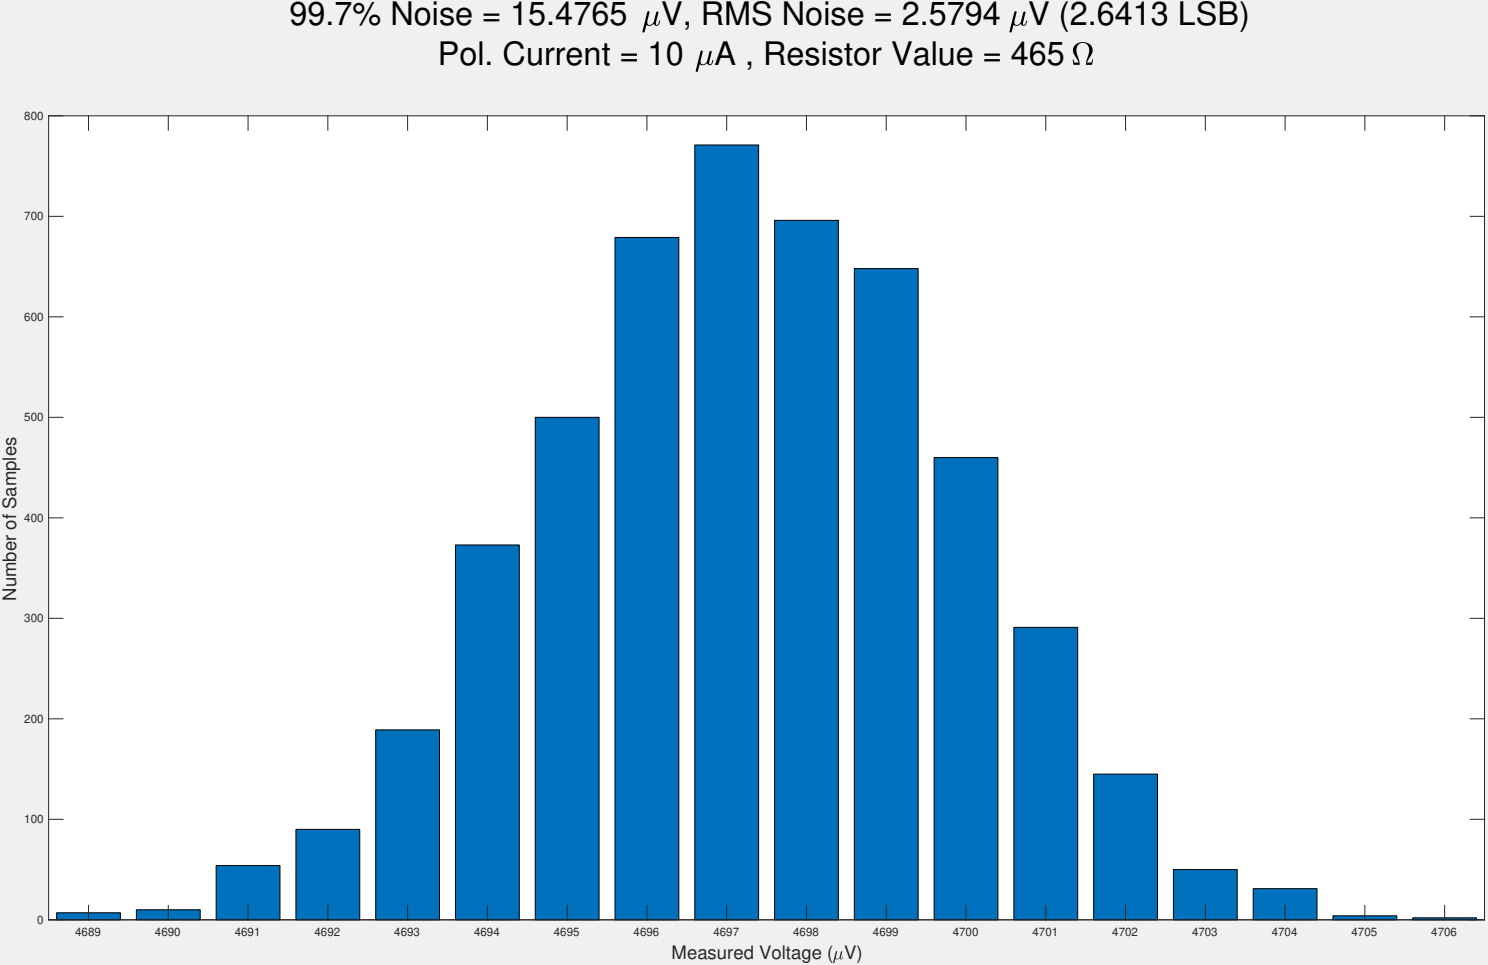
[picture p23: page 6]

99.7% Noise = 15.4765 V, RMS Noise = 2.5794 V (2.6413 LSB)

Pol. Current = 10 A , Resistor Value = 465

Number of Samples

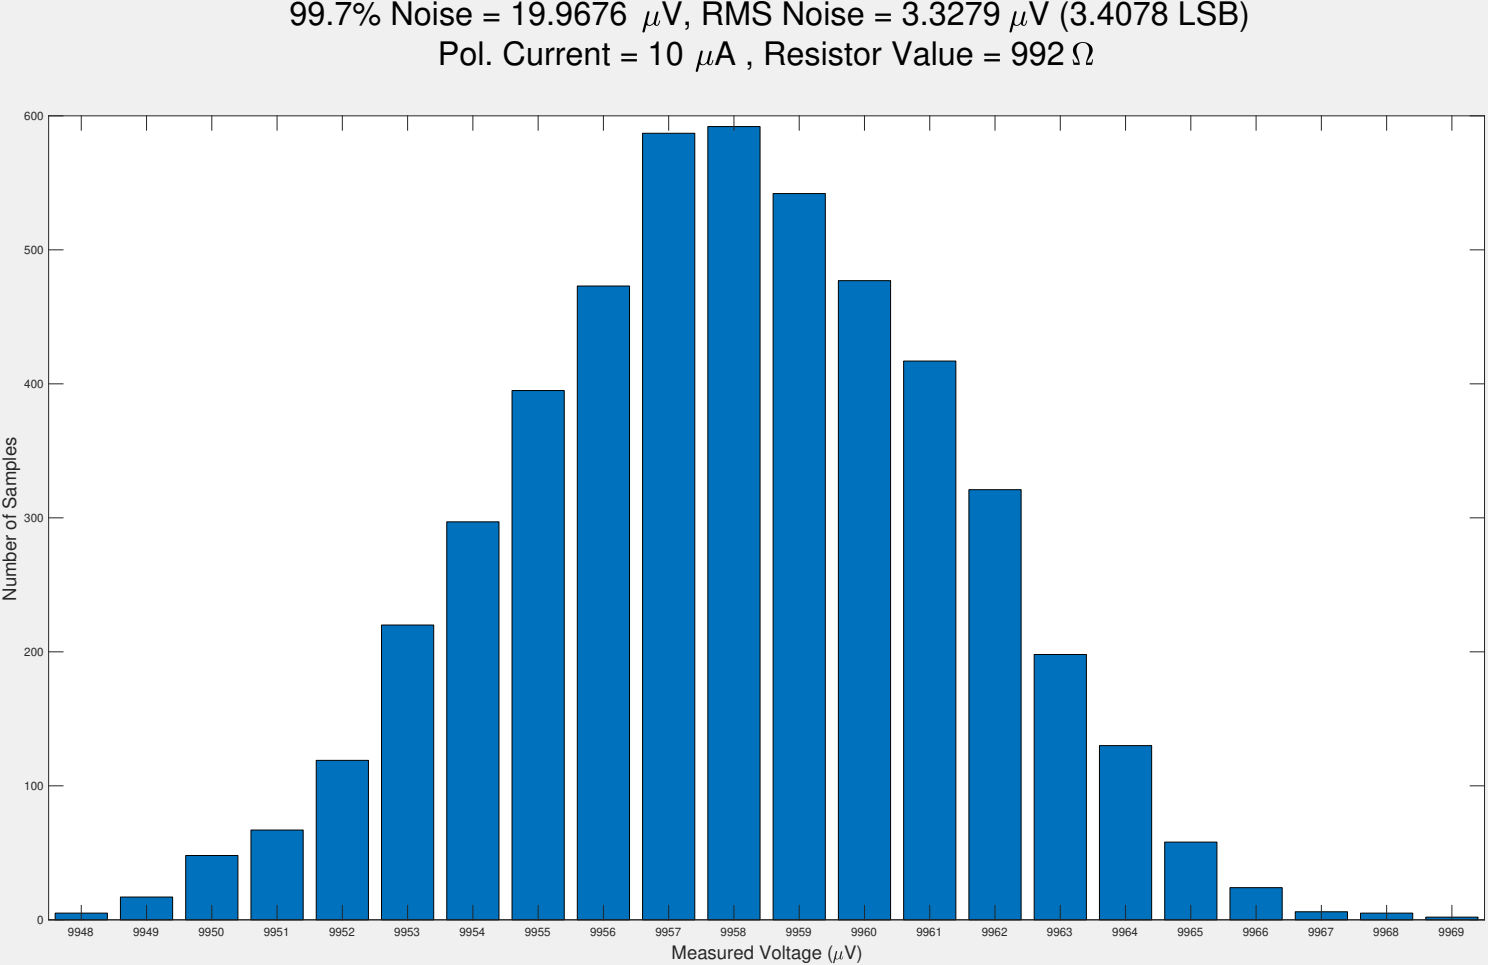
[picture p24: page 7]

99.7% Noise = 19.9676 V, RMS Noise = 3.3279 V (3.4078 LSB)

Pol. Current = 10 A , Resistor Value = 992

Number of Samples

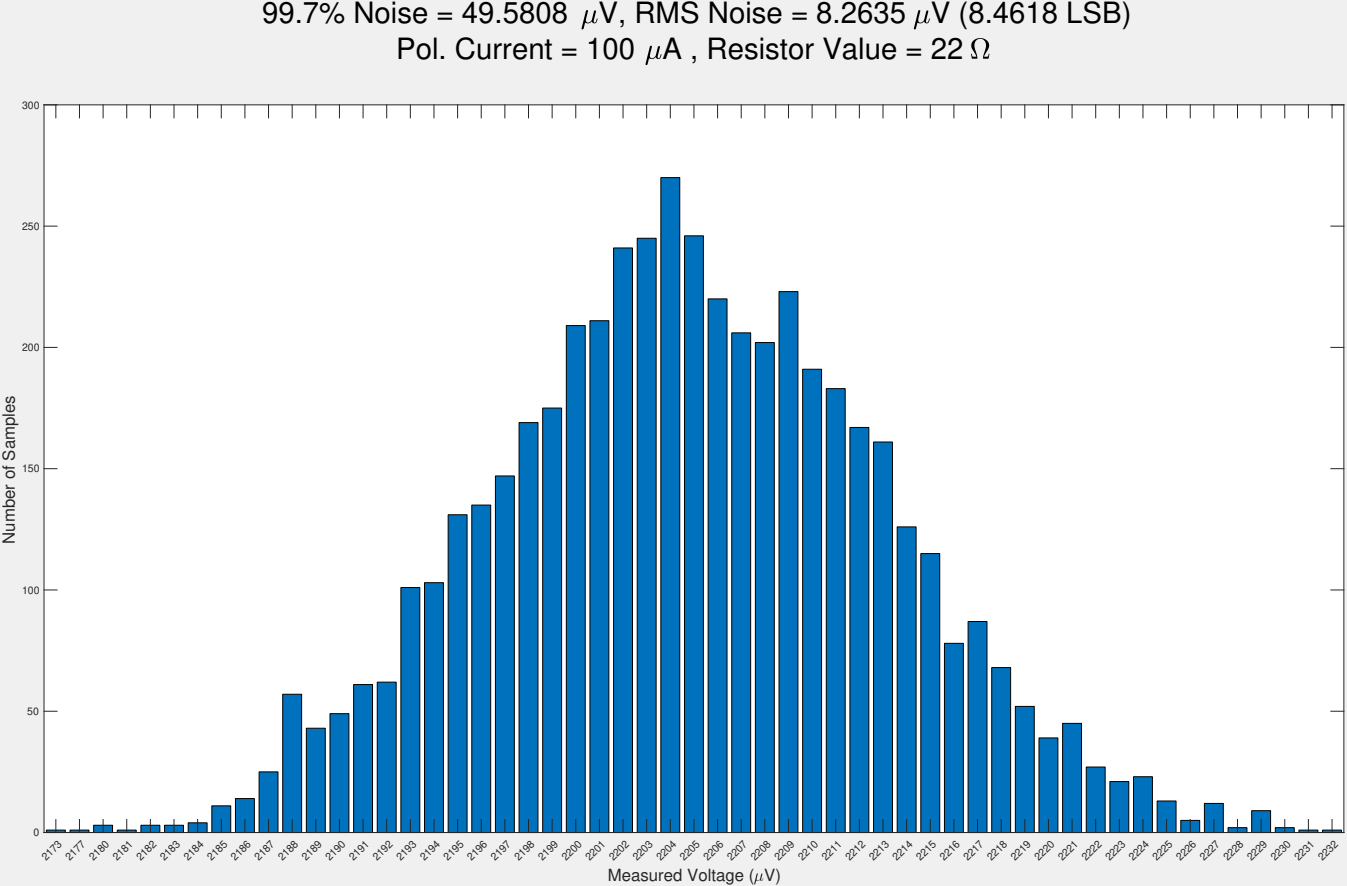
[picture p25: page 8]

99.7% Noise = 49.5808 V, RMS Noise = 8.2635 V (8.4618 LSB)

Pol. Current = 100 A , Resistor Value = 22

Number of Samples

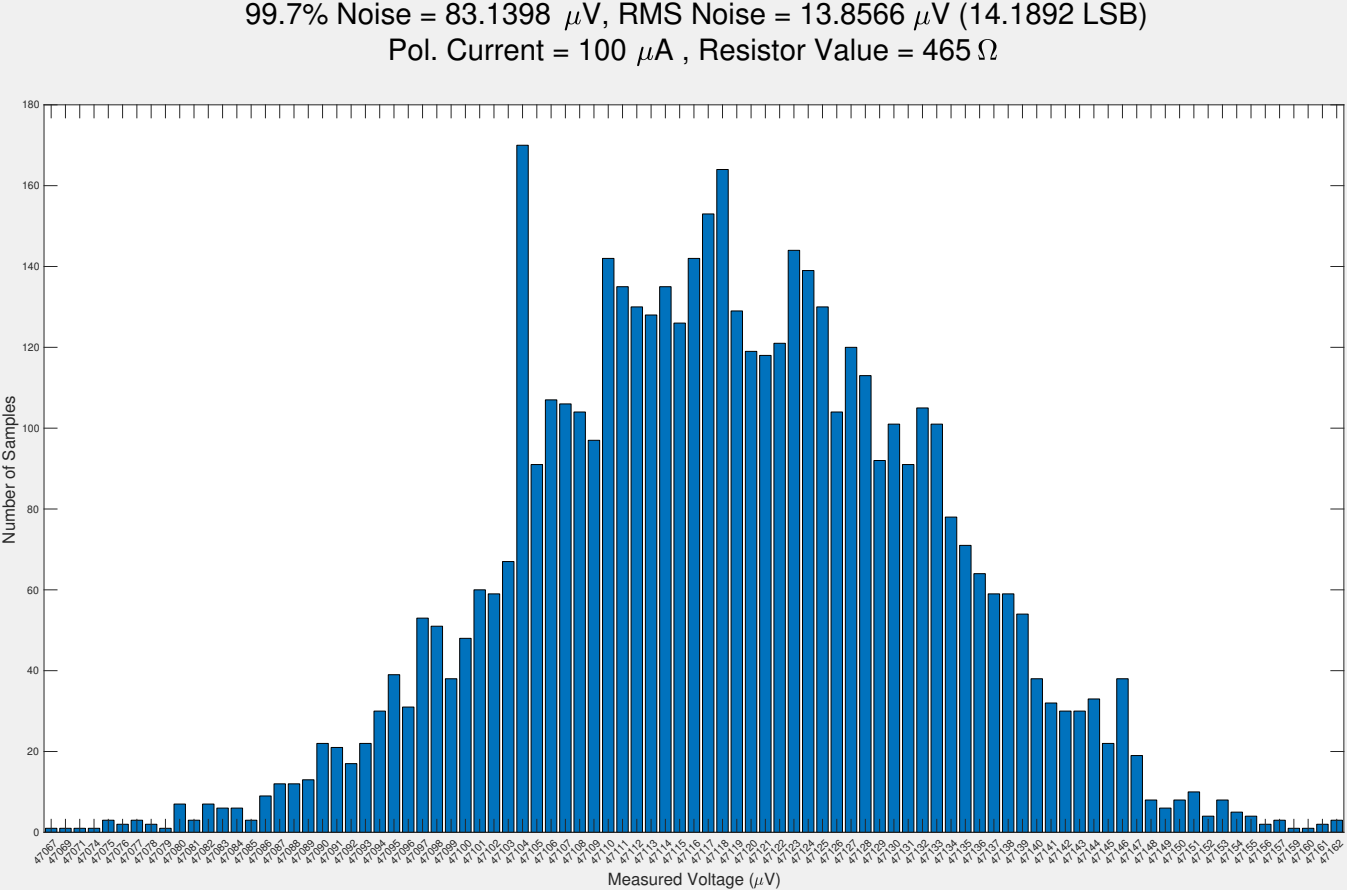
[picture p26: page 9]

99.7% Noise = 83.1398 V, RMS Noise = 13.8566 V (14.1892 LSB)

Pol. Current = 100 A , Resistor Value = 465

Number of Samples

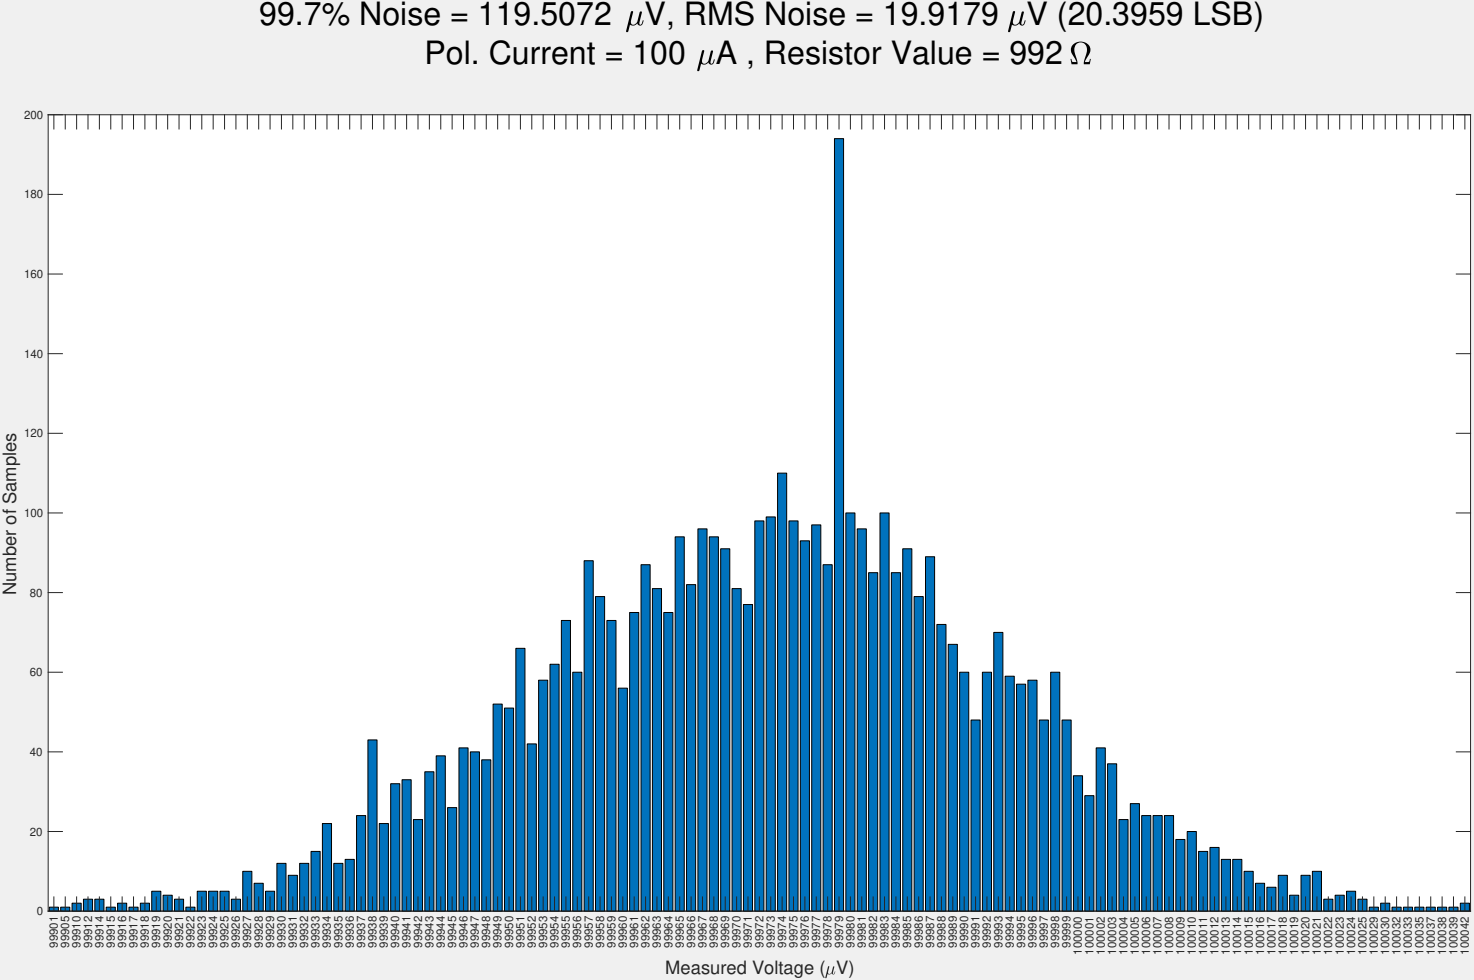
[picture p27: page 10]

99.7% Noise = 119.5072 V, RMS Noise = 19.9179 V (20.3959 LSB)

Pol. Current = 100 A , Resistor Value = 992

Number of Samples
