amantunes/KNoT/results/pdf/21bits.pdf

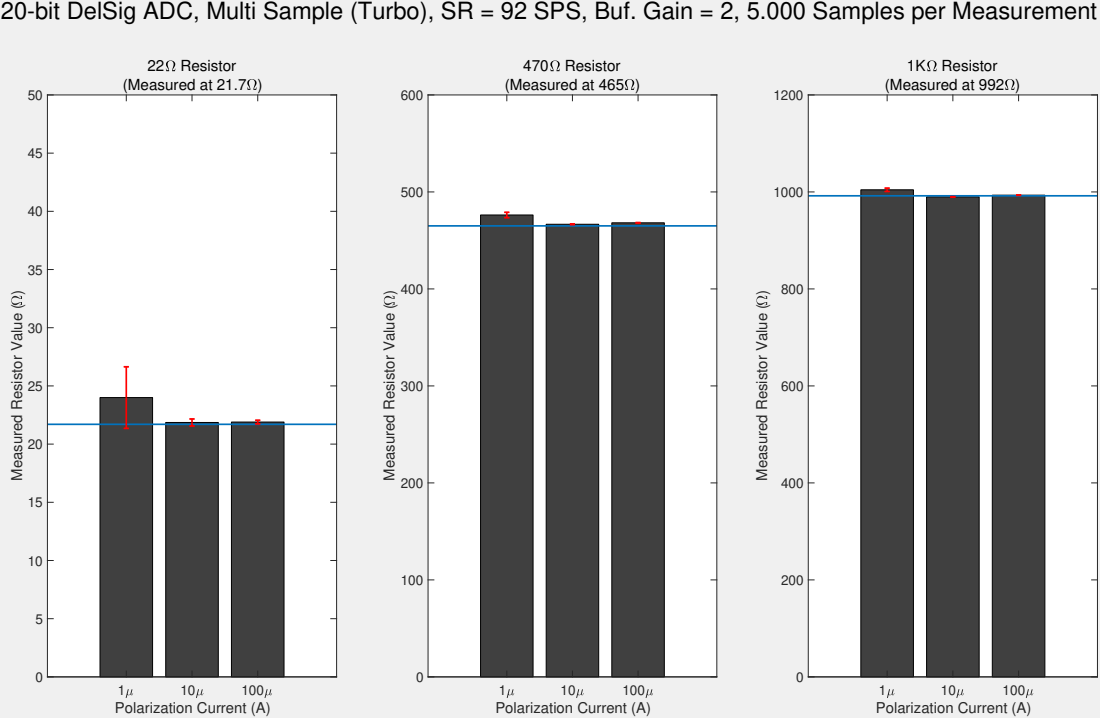
[picture p28: page 1]
22 Resistor (Measured at 21.7 ); Polarization Current (A); 470 Resistor (Measured at 465 ); 1K Resistor (Measured at 992 )

20-bit DelSig ADC, Multi Sample (Turbo), SR = 92 SPS, Buf. Gain = 2, 5.000 Samples per Measurement

Measured Resistor Value ( )

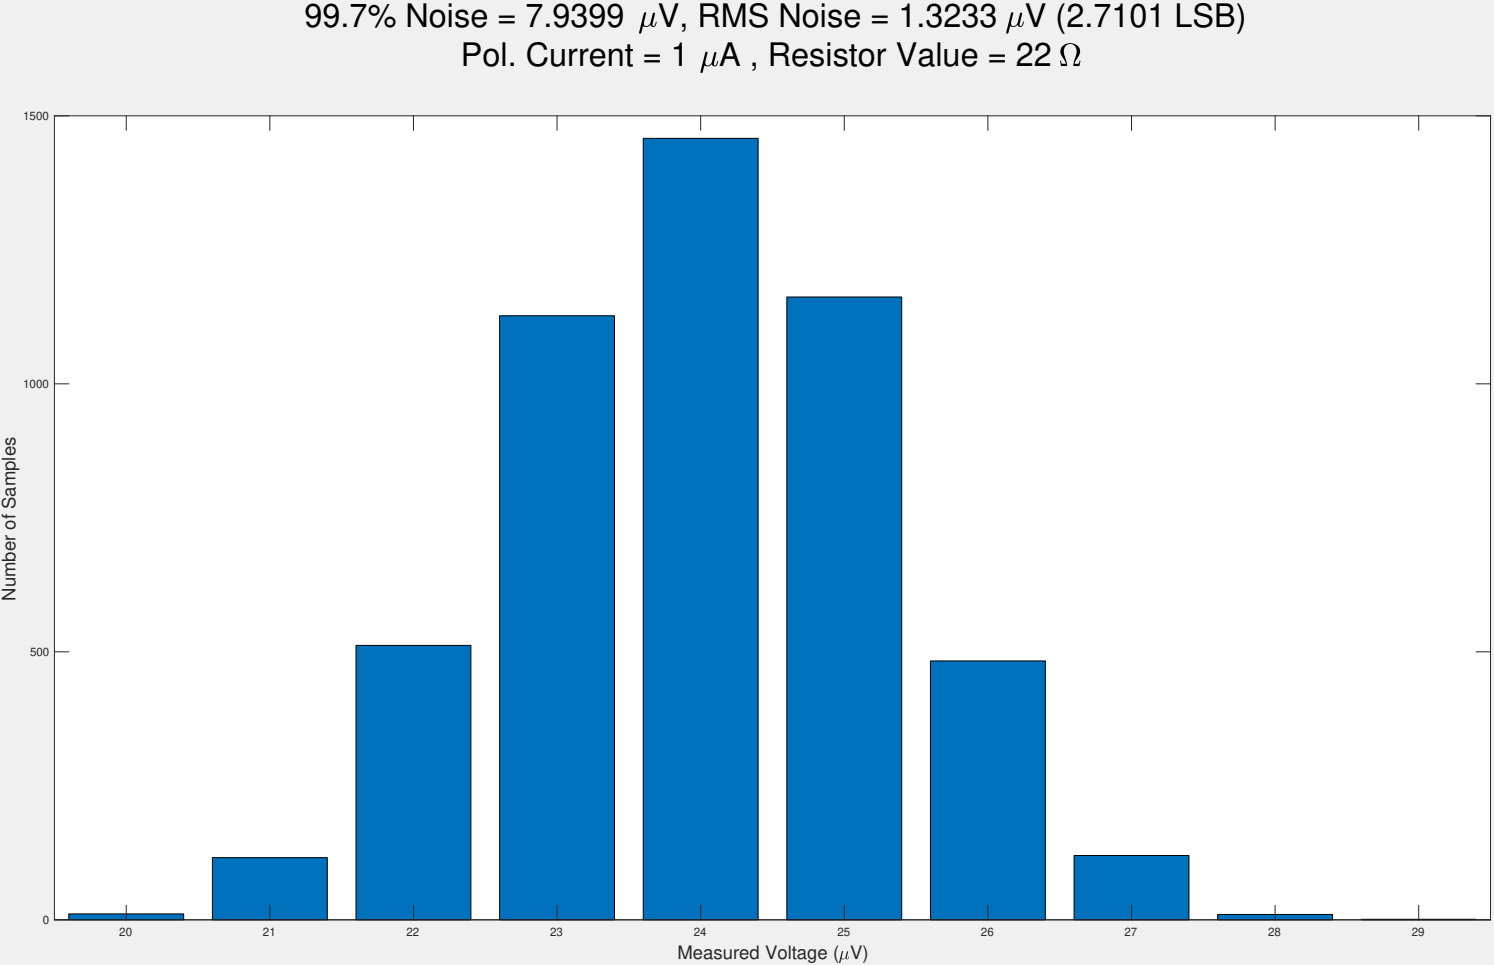
[picture p29: page 2]
Measured Voltage ( V)

99.7% Noise = 7.9399 V, RMS Noise = 1.3233 V (2.7101 LSB)

Pol. Current = 1 A , Resistor Value = 22

Number of Samples

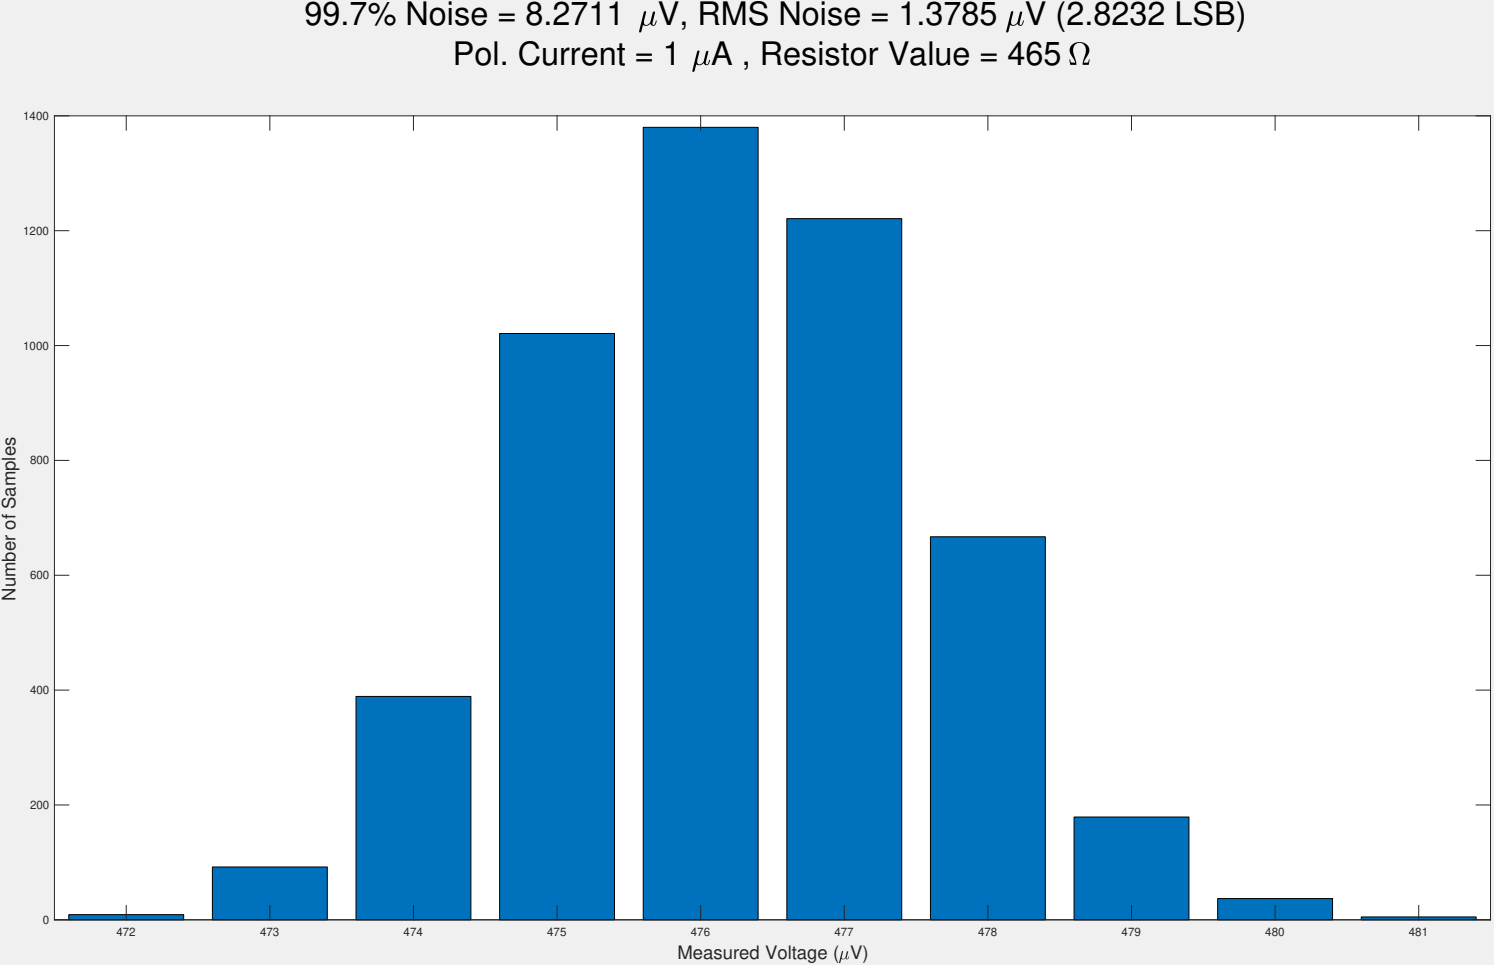
[picture p30: page 3]

99.7% Noise = 8.2711 V, RMS Noise = 1.3785 V (2.8232 LSB)

Pol. Current = 1 A , Resistor Value = 465

Number of Samples

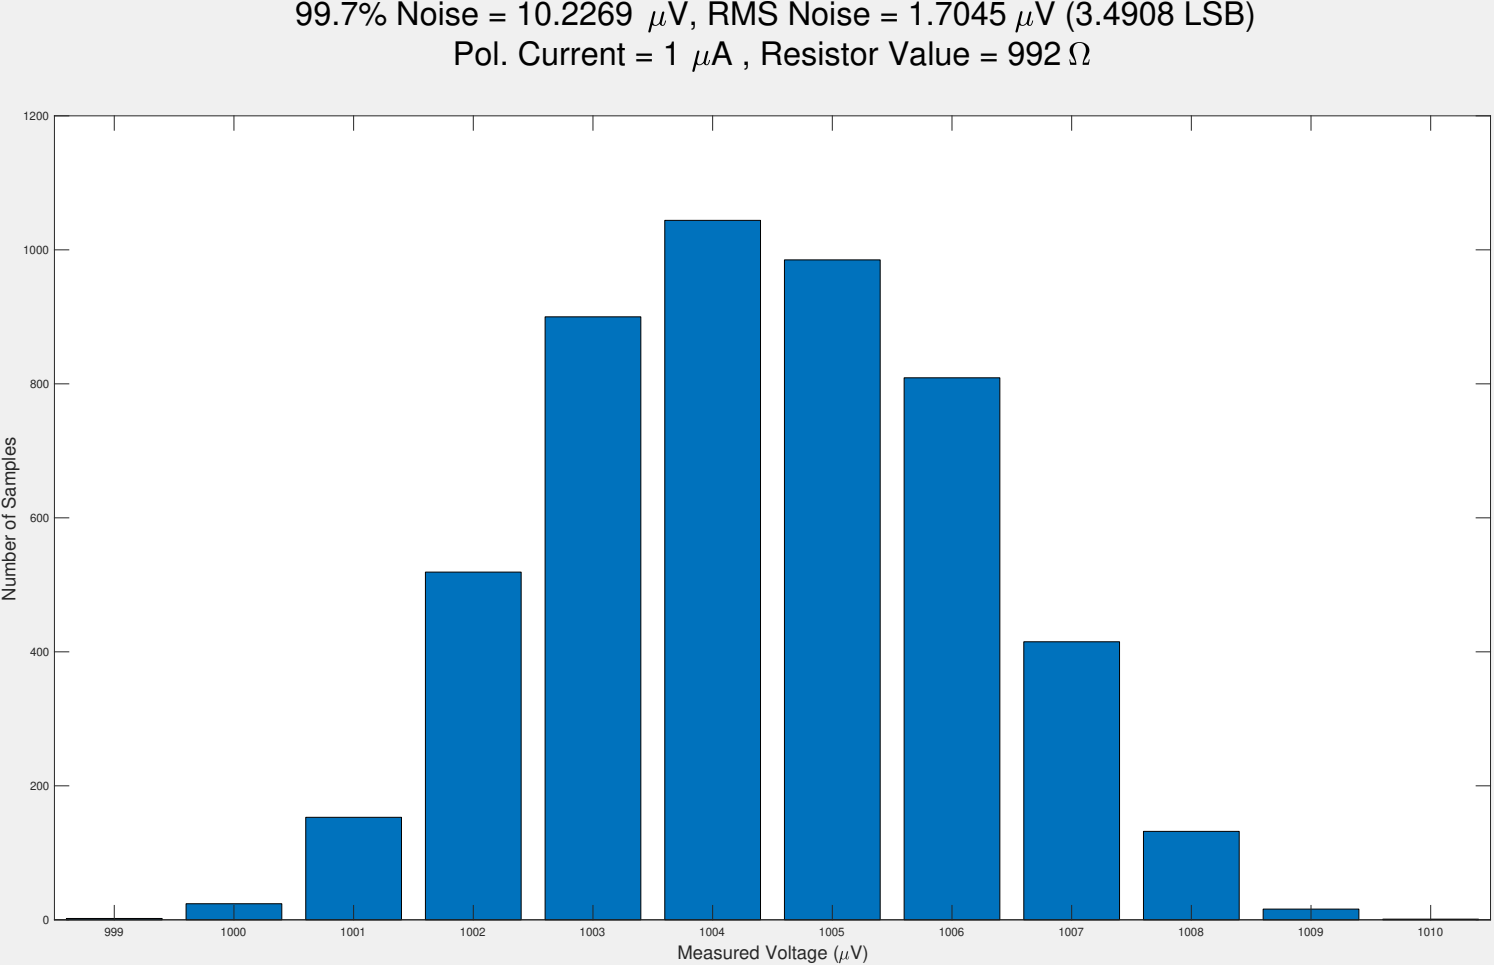
[picture p31: page 4]

99.7% Noise = 10.2269 V, RMS Noise = 1.7045 V (3.4908 LSB)

Pol. Current = 1 A , Resistor Value = 992

Number of Samples

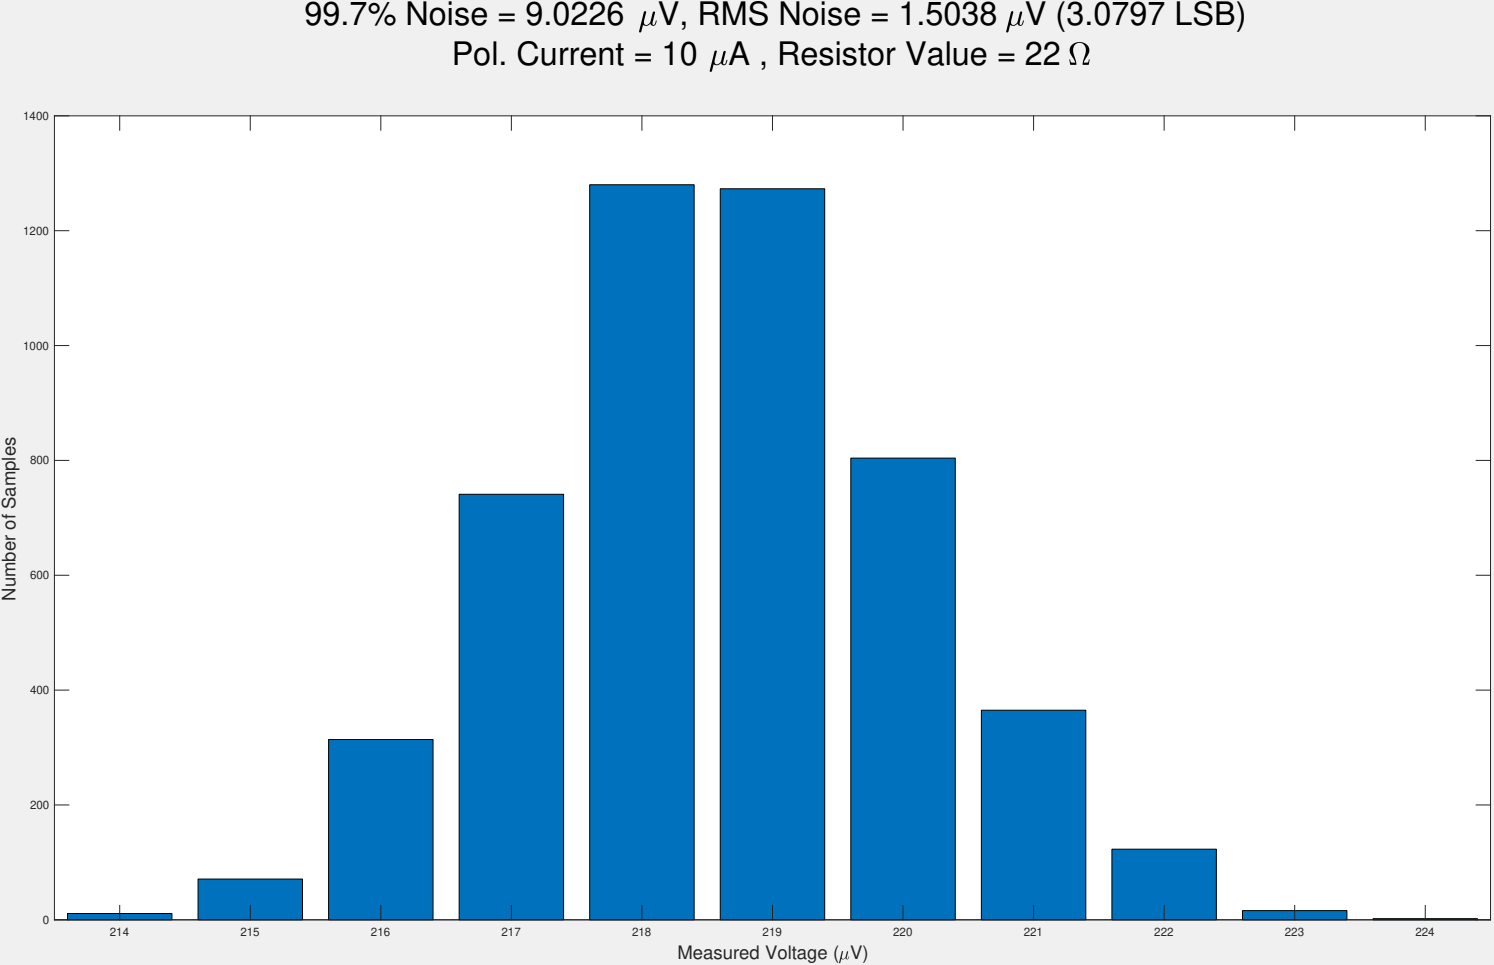
[picture p32: page 5]

99.7% Noise = 9.0226 V, RMS Noise = 1.5038 V (3.0797 LSB)

Pol. Current = 10 A , Resistor Value = 22

Number of Samples

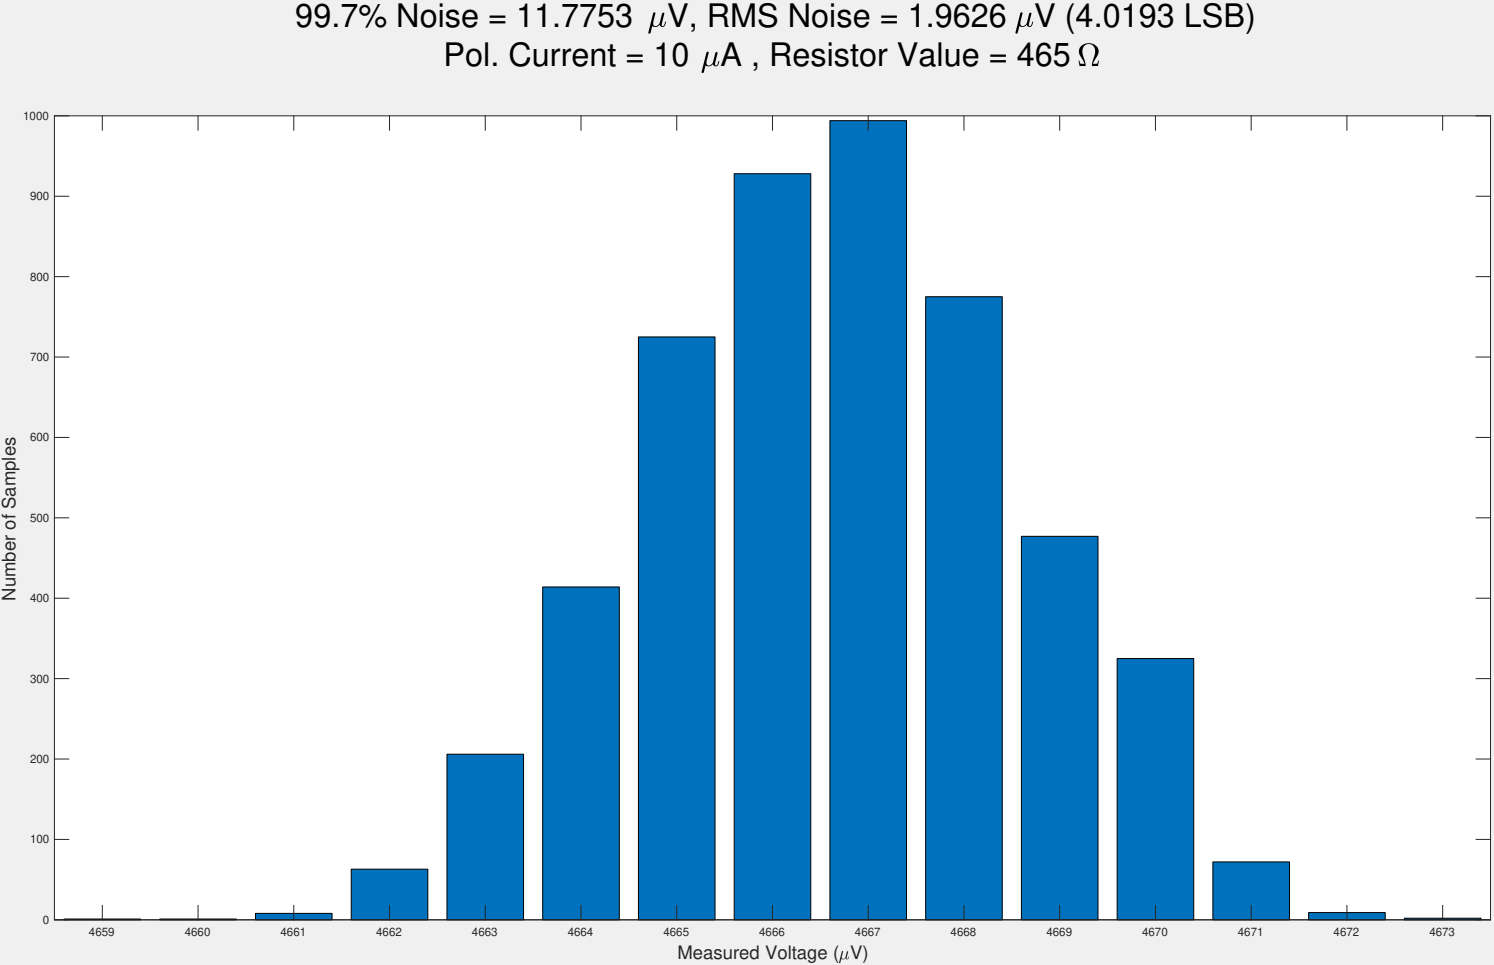
[picture p33: page 6]

99.7% Noise = 11.7753 V, RMS Noise = 1.9626 V (4.0193 LSB)

Pol. Current = 10 A , Resistor Value = 465

Number of Samples

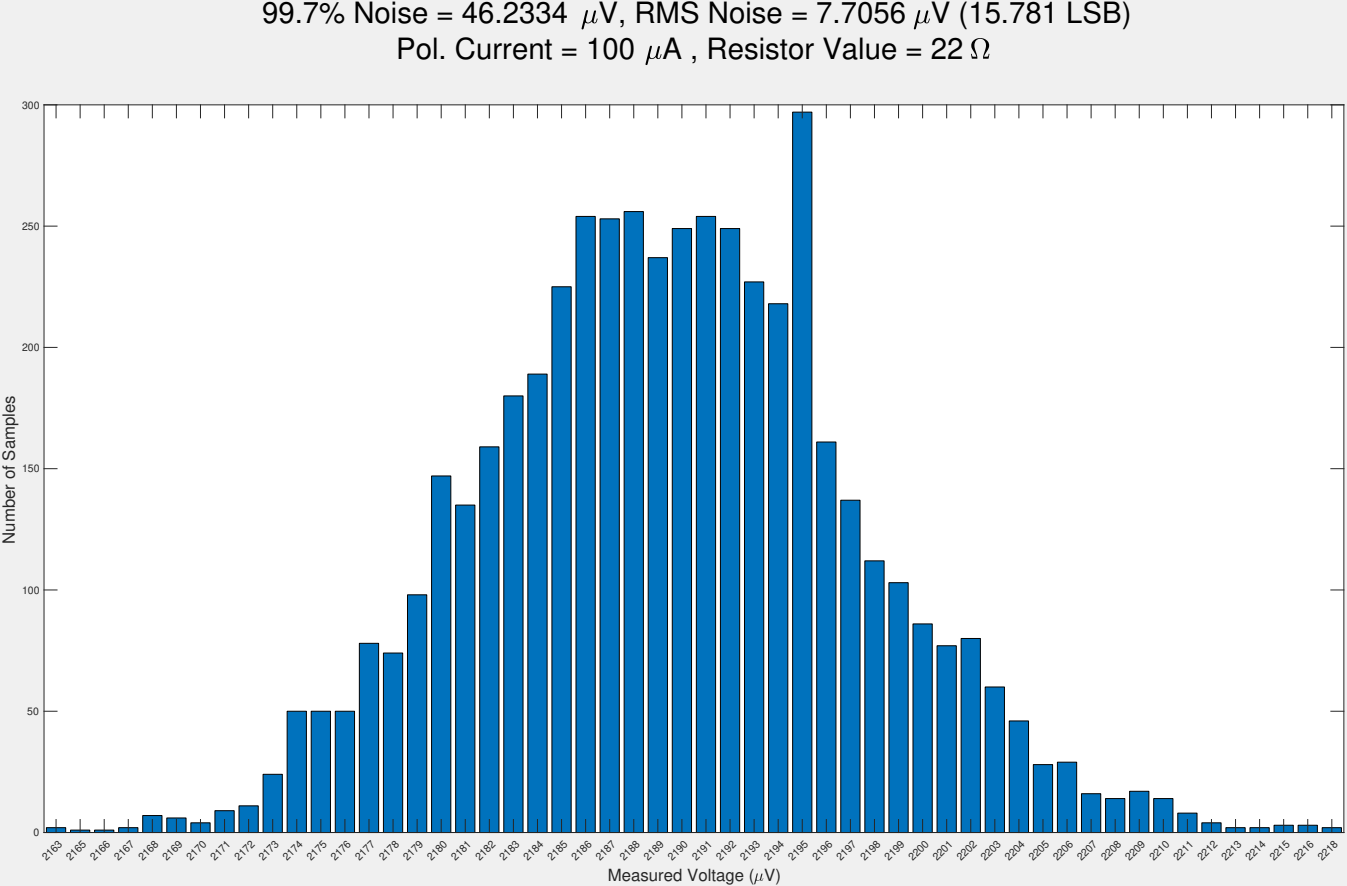
[picture p34: page 8]

99.7% Noise = 46.2334 V, RMS Noise = 7.7056 V (15.781 LSB)

Pol. Current = 100 A , Resistor Value = 22

Number of Samples

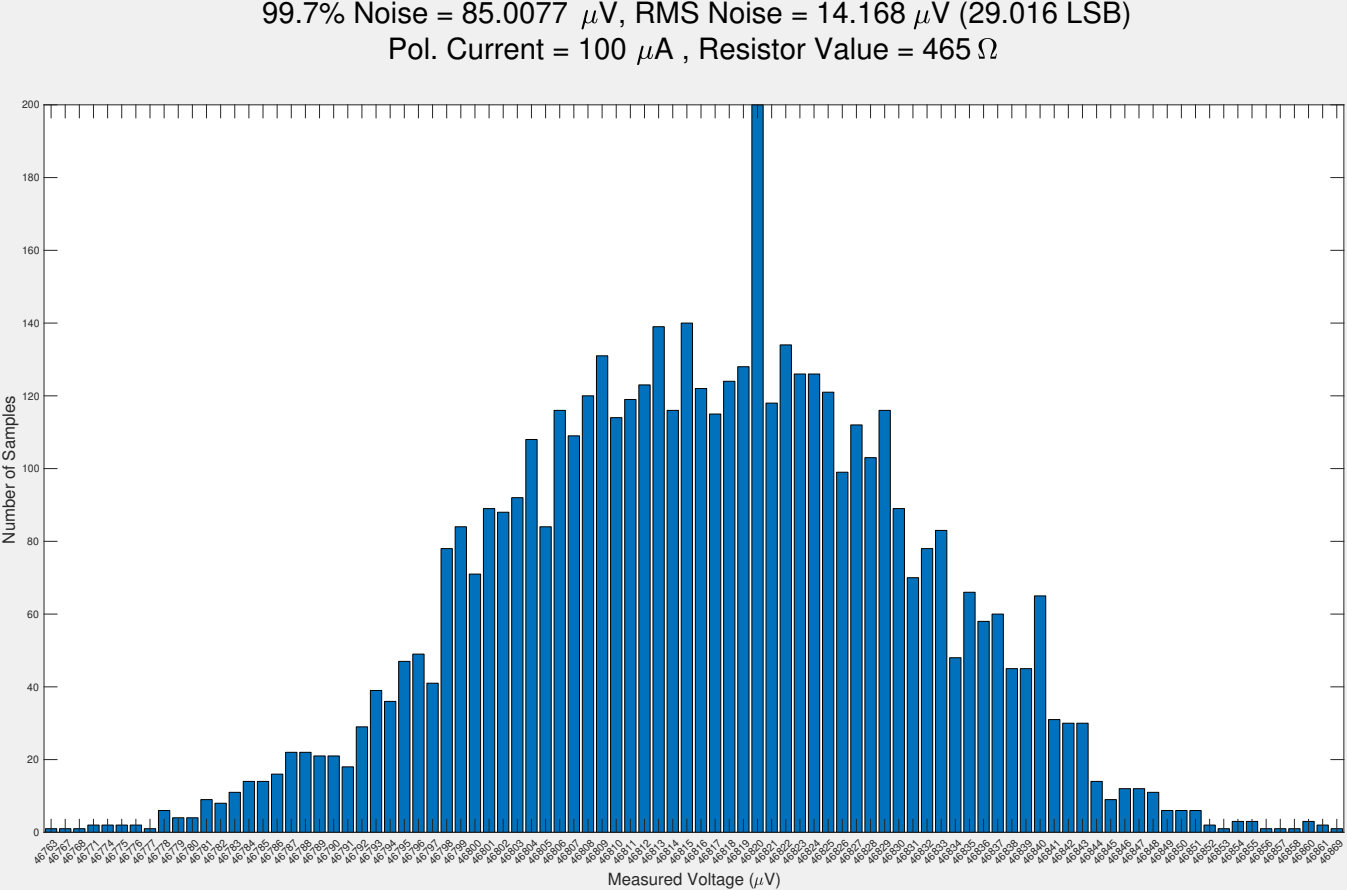
[picture p35: page 9]

99.7% Noise = 85.0077 V, RMS Noise = 14.168 V (29.016 LSB)

Pol. Current = 100 A , Resistor Value = 465

Number of Samples

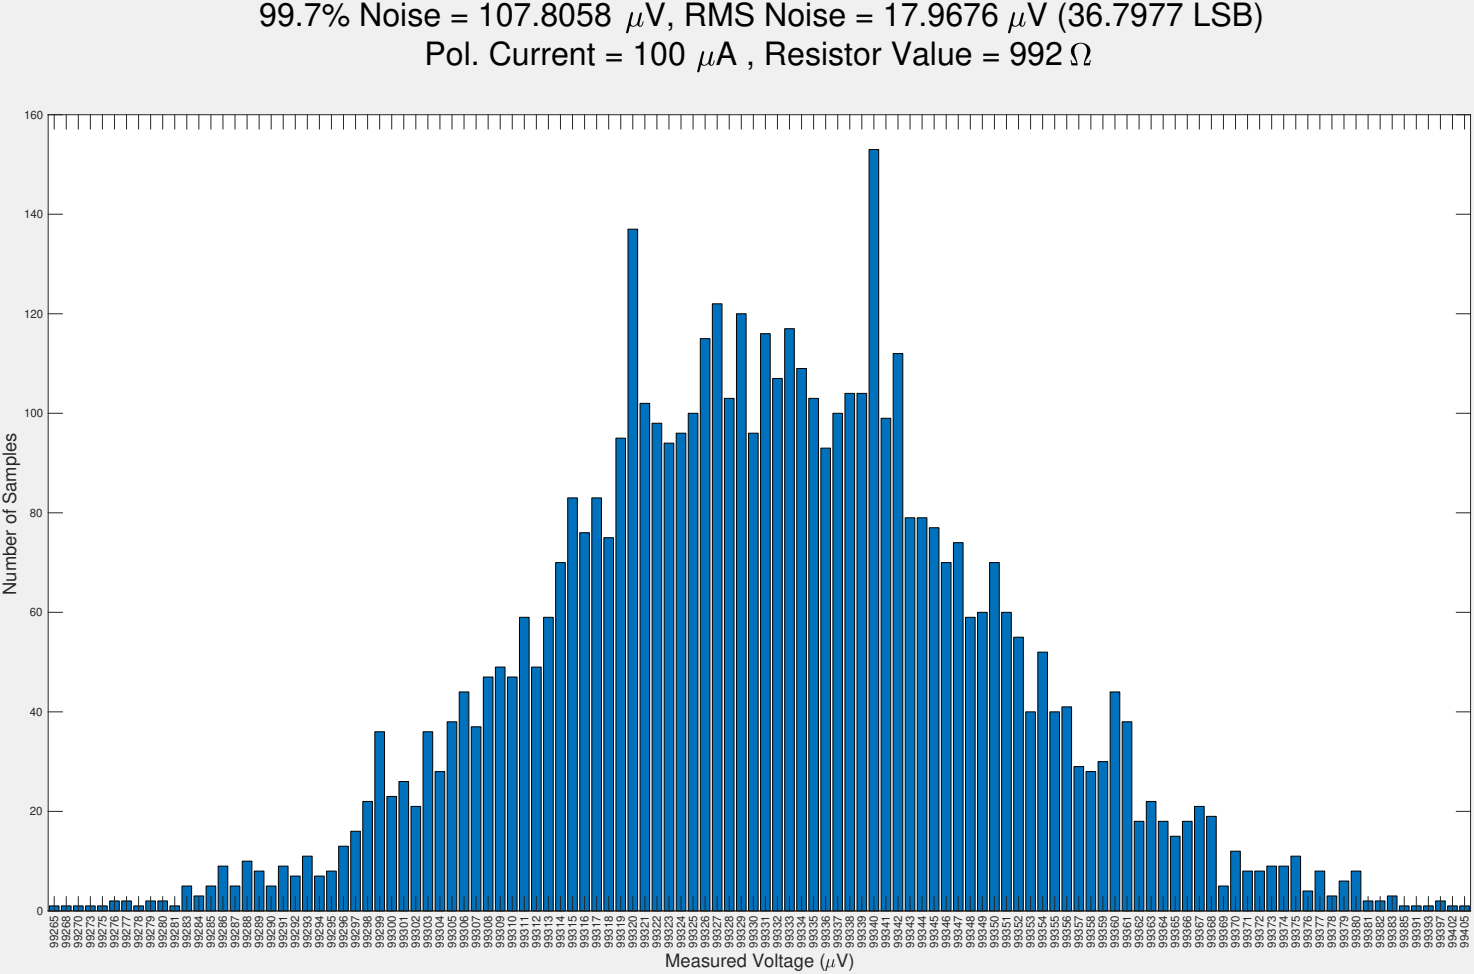
[picture p36: page 10]

99.7% Noise = 107.8058 V, RMS Noise = 17.9676 V (36.7977 LSB)

Pol. Current = 100 A , Resistor Value = 992

Number of Samples
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
