amantunes/KNoT/kicad/mainboard/IoT Sensor Node.kicad_pcb

## KiCad design kicad/mainboard/IoT Sensor Node.kicad_pcb (2021-01-19)

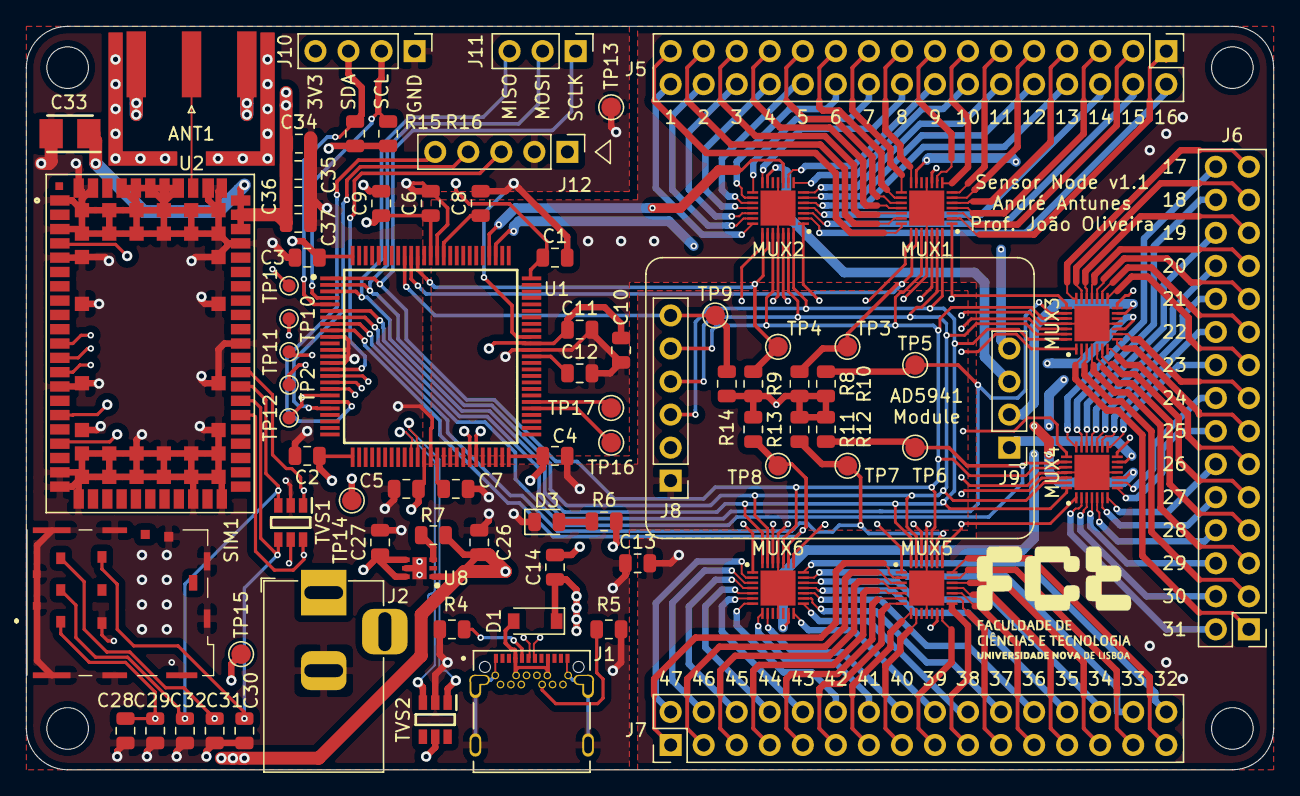
[picture p37: board kicad/mainboard/IoT Sensor Node.kicad_pcb from above]

Board: 4 copper layers, 95.9 x 57.2 mm, 81 parts (0 on the bottom side), 147 nets.

Parts:
ANT1: Conn_Coaxial; SMA_Amphenol_132289_EdgeMount
C1, C2, C3, C4, C5, C6, C11, C28, C34: 0.1uF; C_0805_2012Metric
C7, C8, C9, C10, C12, C13, C14: 1uF; C_0805_2012Metric
C26, C27: 4.7uF; C_0805_2012Metric
C29, C30, C31, C32: 33pF; C_0805_2012Metric
C33: 100uF; CAPPM3528X210N
C35: 10nF; C_0805_2012Metric
C36: 68pF; C_0805_2012Metric
C37: 15pF; C_0805_2012Metric
D1: PMEG2010ER; D_SOD-123
D3: LED; LED_0805_2012Metric
J1: UJ31-CH-31N-SMT-TR; CUI_UJ31-CH-3-SMT-TR
J2: Jack-DC; BarrelJack_Horizontal
J5, J7: Conn_02x16_Odd_Even; PinHeader_2x16_P2.54mm_Vertical
J6: Conn_02x15_Odd_Even; PinHeader_2x15_P2.54mm_Vertical
J8: Conn_01x06; PinHeader_1x06_P2.54mm_Vertical
J9, J10: Conn_01x04; PinHeader_1x04_P2.54mm_Vertical
J11: Conn_01x03; PinHeader_1x03_P2.54mm_Vertical
J12: Conn_01x05; PinHeader_1x05_P2.54mm_Vertical
MUX1, MUX2, MUX3, MUX4, MUX5, MUX6: MAX14661ETI+; QFN40P400X400X80-29N
R4, R5: 5.1KR; R_0805_2012Metric
R6: 1KR; R_0805_2012Metric
R7, R8, R9, R10, R11, R12, R13, R14, R15, R16: 10KR; R_0805_2012Metric
SIM1: SF72S006VBAR2500
TP1, TP2, TP10, TP11, TP12: TestPoint; TestPoint_Pad_D1.0mm
TP3, TP4, TP5, TP6, TP7, TP8, TP9, TP13, TP14, TP15, TP16, TP17: TestPoint; TestPoint_Pad_D1.5mm
TVS1, TVS2: CM1293A-04SO; SOP95P275X110-6N
U1: CY8C5888AXI-LP096; QFP50P1600X1600X145-100N
U2: SARA-N210
U8: LP5912-3.3DRVR; SON65P200X200X80-7N

Connections:
3.3V: C3.1, C26.1, C33.1, C34.1, C35.1, C36.1, C37.1, J8.2, J10.4, MUX1.1, MUX1.22, MUX1.26, MUX2.1, MUX2.22, MUX2.26, MUX3.1, MUX3.22, MUX3.26, MUX4.1, MUX4.22, MUX4.26, MUX5.1, MUX5.22, MUX5.26, MUX6.1, MUX6.22, MUX6.26, R6.2, R7.2, R8.2, R9.2, R10.2, R11.2, R12.2, R13.2, R14.2, R15.2, R16.2, TP15.1, U1.100, U2.51, U2.52, U2.53, U8.1
AD5941_CS: J8.6, R14.1, TP9.1, U1.92
I2C_3V3_SCL: J10.2, R16.1, U1.4
I2C_3V3_SDA: J10.3, R15.1, U1.5
MUX1_1: J5.1, MUX1.2
MUX1_2: J5.3, MUX1.3
MUX1_3: J5.5, MUX1.4
MUX1_4: J5.7, MUX1.5
MUX1_5: J5.9, MUX1.6
MUX1_6: J5.11, MUX1.7
MUX1_7: J5.13, MUX1.8
MUX1_8: J5.15, MUX1.9
MUX1_9: J5.31, MUX1.21
MUX1_10: J5.29, MUX1.20
MUX1_11: J5.27, MUX1.19
MUX1_12: J5.25, MUX1.18
MUX1_13: J5.23, MUX1.17
MUX1_14: J5.21, MUX1.16
MUX1_15: J5.19, MUX1.15
MUX1_16: J5.17, MUX1.14
MUX1_A: MUX1.10, U1.78
MUX1_B: J9.4, MUX1.13
MUX1_CS: MUX1.23, R8.1, TP3.1, U1.91
MUX2_1: J5.2, MUX2.2
MUX2_2: J5.4, MUX2.3
MUX2_3: J5.6, MUX2.4
MUX2_4: J5.8, MUX2.5
MUX2_5: J5.10, MUX2.6
MUX2_6: J5.12, MUX2.7
MUX2_7: J5.14, MUX2.8
MUX2_8: J5.16, MUX2.9
MUX2_9: J5.32, MUX2.21
MUX2_10: J5.30, MUX2.20
MUX2_11: J5.28, MUX2.19
MUX2_12: J5.26, MUX2.18
MUX2_13: J5.24, MUX2.17
MUX2_14: J5.22, MUX2.16
MUX2_15: J5.20, MUX2.15
MUX2_16: J5.18, MUX2.14
MUX2_A: MUX2.10, U1.79
MUX2_B: J9.3, MUX2.13
MUX2_CS: MUX2.23, R9.1, TP4.1, U1.90
MUX3_1: J6.1, MUX3.2
MUX3_2: J6.3, MUX3.3
MUX3_3: J6.5, MUX3.4
MUX3_4: J6.7, MUX3.5
MUX3_5: J6.9, MUX3.6
MUX3_6: J6.11, MUX3.7
MUX3_7: J6.13, MUX3.8
MUX3_8: J6.15, MUX3.9
MUX3_9: J6.29, MUX3.21
MUX3_10: J6.27, MUX3.20
MUX3_11: J6.25, MUX3.19
MUX3_12: J6.23, MUX3.18
MUX3_13: J6.21, MUX3.17
MUX3_14: J6.19, MUX3.16
MUX3_15: J6.17, MUX3.15
MUX3_A: MUX3.10, U1.44
MUX3_B: J9.2, MUX3.13
MUX3_CS: MUX3.23, R10.1, TP5.1, U1.6
MUX4_1: J6.2, MUX4.2
MUX4_2: J6.4, MUX4.3
MUX4_3: J6.6, MUX4.4
MUX4_4: J6.8, MUX4.5
MUX4_5: J6.10, MUX4.6
MUX4_6: J6.12, MUX4.7
MUX4_7: J6.14, MUX4.8
MUX4_8: J6.16, MUX4.9
MUX4_9: J6.30, MUX4.21
MUX4_10: J6.28, MUX4.20
MUX4_11: J6.26, MUX4.19
MUX4_12: J6.24, MUX4.18
MUX4_13: J6.22, MUX4.17
MUX4_14: J6.20, MUX4.16
MUX4_15: J6.18, MUX4.15
MUX4_A: MUX4.10, U1.45
MUX4_B: J9.1, MUX4.13
MUX4_CS: MUX4.23, R11.1, TP6.1, U1.7
MUX5_1: J7.1, MUX5.2
MUX5_2: J7.3, MUX5.3
MUX5_3: J7.5, MUX5.4
MUX5_4: J7.7, MUX5.5
MUX5_5: J7.9, MUX5.6
MUX5_6: J7.11, MUX5.7
MUX5_7: J7.13, MUX5.8
MUX5_8: J7.15, MUX5.9
MUX5_9: J7.31, MUX5.21
MUX5_10: J7.29, MUX5.20
MUX5_11: J7.27, MUX5.19
MUX5_12: J7.25, MUX5.18
MUX5_13: J7.23, MUX5.17
MUX5_14: J7.21, MUX5.16
MUX5_15: J7.19, MUX5.15
MUX5_16: J7.17, MUX5.14
MUX5_B: MUX4.14, MUX5.13
MUX5_CS: MUX5.23, R12.1, TP7.1, U1.8
MUX6_1: J7.2, MUX6.2
MUX6_2: J7.4, MUX6.3
MUX6_3: J7.6, MUX6.4
MUX6_4: J7.8, MUX6.5
MUX6_5: J7.10, MUX6.6
MUX6_6: J7.12, MUX6.7
MUX6_7: J7.14, MUX6.8
MUX6_8: J7.16, MUX6.9
MUX6_9: J7.32, MUX6.21
MUX6_10: J7.30, MUX6.20
MUX6_11: J7.28, MUX6.19
MUX6_12: J7.26, MUX6.18
MUX6_13: J7.24, MUX6.17
MUX6_14: J7.22, MUX6.16
MUX6_15: J7.20, MUX6.15
MUX6_16: J7.18, MUX6.14
MUX6_B: MUX3.14, MUX6.13
MUX6_CS: MUX6.23, R13.1, TP8.1, U1.9
unnamed: D1.2, J1.A4, J1.A9, J1.B4, J1.B9
unnamed: D3.2, R6.1
unnamed: J1.A5, R4.1
unnamed: J1.B5, R5.1
unnamed: R7.1, U8.3
unnamed: TP1.1, U2.4
unnamed: TP2.1, U2.16
unnamed: TP16.1, U1.55
unnamed: TP17.1, U1.56
RST: J12.3, U1.15
SARA_ANT: ANT1.1, U2.56
SARA_CTS: U1.16, U2.11
SARA_RESET: TP12.1, U1.19, U2.18
SARA_RXD: TP11.1, U1.18, U2.13
SARA_SIM_CLK: C31.1, SIM1.C3, TVS1.6, U2.38
SARA_SIM_IO: C30.1, SIM1.C7, TVS1.4, U2.39
SARA_SIM_RST: C32.1, SIM1.C2, TVS1.3, U2.40
SARA_TXD: TP10.1, U1.17, U2.12
SARA_VSIM: C28.1, C29.1, SIM1.C1, TVS1.1, U2.41
SPI_MISO: J8.3, J11.3, MUX1.28, MUX2.28, MUX3.28, MUX4.28, MUX5.28, MUX6.28, U1.3
SPI_MOSI: J8.4, J11.2, MUX1.27, MUX2.27, MUX3.27, MUX4.27, MUX5.27, MUX6.27, U1.2
SPI_SCLK: J8.5, J11.1, MUX1.24, MUX2.24, MUX3.24, MUX4.24, MUX5.24, MUX6.24, U1.1
SWDCLK: J12.4, U1.21
SWDIO: J12.5, U1.20
USB+: J1.A6, J1.B6, TVS2.3, U1.35
USB-: J1.A7, J1.B7, TVS2.1, U1.36
VBAT: ANT1.2, C1.2, C2.2, C3.2, C4.2, C5.2, C6.2, C7.2, C8.2, C9.2, C13.1, C26.2, C27.2, C28.2, C29.2, C30.2, C31.2, C32.2, C33.2, C34.2, C35.2, C36.2, C37.2, D3.1, J1.A1, J1.A12, J1.B1, J1.B12, J1.SH1, J1.SH2, J1.SH3, J1.SH4, J1.SH5, J1.SH6, J2.2, J8.1, J10.1, J12.2, MUX1.11, MUX1.25, MUX1.29, MUX2.11, MUX2.25, MUX2.29, MUX3.11, MUX3.25, MUX3.29, MUX4.11, MUX4.25, MUX4.29, MUX5.11, MUX5.25, MUX5.29, MUX6.11, MUX6.25, MUX6.29, R4.2, R5.2, SIM1.C5, SIM1.GND1, SIM1.GND2, SIM1.GND3, SIM1.GND4, SIM1.GND5, SIM1.GND6, SIM1.GND7, SIM1.GND8, SIM1.GND9, SIM1.GND10, TP13.1, TVS1.2, TVS2.2, U1.10, U1.12, U1.13, U1.14, U1.38, U1.66, U1.87, U2.1, U2.3, U2.5, U2.14, U2.20, U2.21, U2.22, U2.30, U2.32, U2.43, U2.50, U2.54, U2.55, U2.57, U2.58, U2.59, U2.60, U2.61, U2.63, U2.64, U2.65, U2.66, U2.67, U2.68, U2.69, U2.70, U2.71, U2.72, U2.73, U2.74, U2.75, U2.76, U2.77, U2.78, U2.79, U2.80, U2.81, U2.82, U2.83, U2.84, U2.85, U2.86, U2.87, U2.88, U2.89, U2.90, U2.91, U2.92, U2.93, U2.94, U2.95, U2.96, U8.5, U8.7
VCC1: C7.1, U1.39
VCC2: C8.1, U1.86
VCCA: C12.1, U1.63
VDD1: C1.1, C2.1, C4.1, C5.1, C6.1, C9.1, C14.1, C27.1, D1.1, J2.1, J12.1, TP14.1, TVS1.5, TVS2.5, U1.26, U1.37, U1.50, U1.75, U1.88, U8.4, U8.6
VDDA: C10.1, C11.1, C14.2, U1.65
VSSA: C10.2, C11.2, C12.2, C13.2, U1.64
