amantunes/KNoT/kicad/daughter/IoT Sensor Node.kicad_pcb

## KiCad design kicad/daughter/IoT Sensor Node.kicad_pcb (2021-01-19)

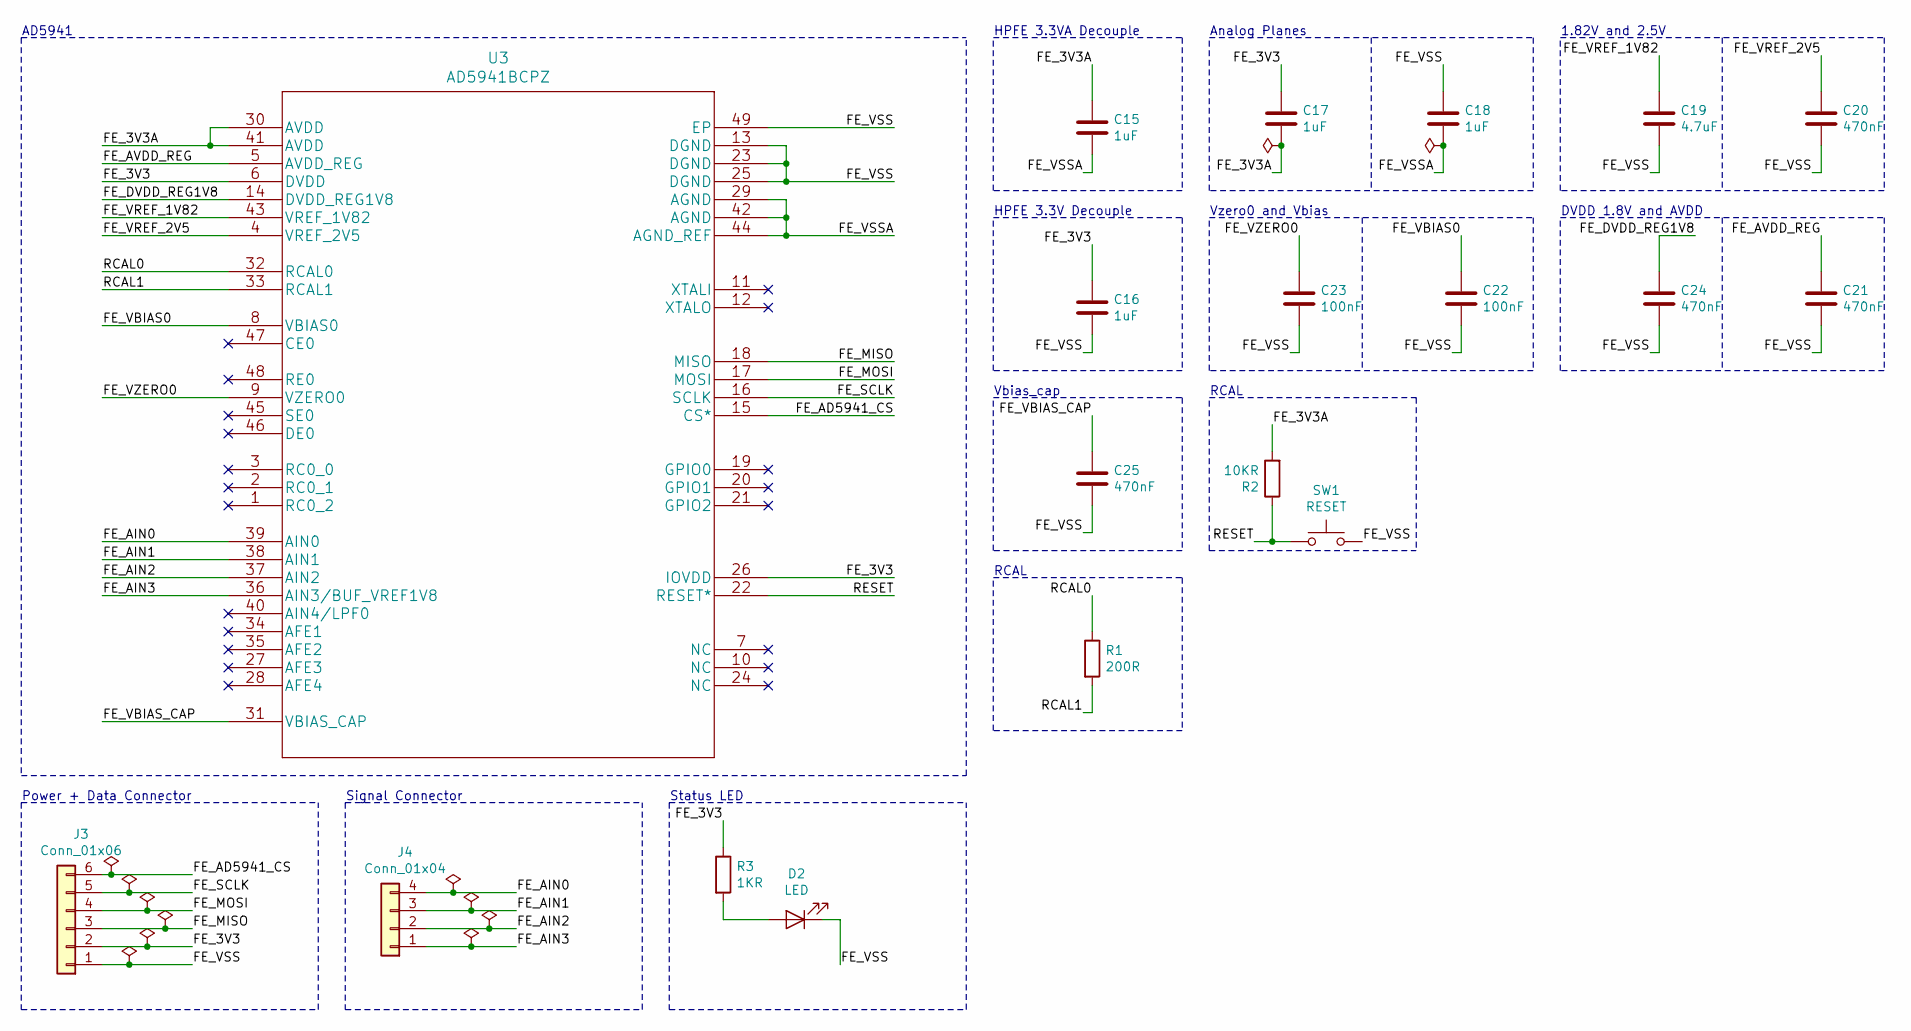
[picture p38: schematic IoT Sensor Node HPFE.sch]

Parts:
C15, C16, C17, C18: 1uF; C_0805_2012Metric
C19: 4.7uF; C_0805_2012Metric
C20, C21, C24, C25: 470nF; C_0805_2012Metric
C22, C23: 100nF; C_0805_2012Metric
D2: LED; LED_0805_2012Metric
J3: Conn_01x06; PinSocket_1x06_P2.54mm_Vertical
J4: Conn_01x04; PinSocket_1x04_P2.54mm_Vertical
R1: 200R; R_0805_2012Metric
R2: 10KR; R_0805_2012Metric
R3: 1KR; R_0805_2012Metric
SW1: RESET; PTS815SJM250SMTR
U3: AD5941BCPZ; QFN50P700X700X80-49N-D

Connections:
/IoT Sensor Node HPFE/FE_3V3: C16.1, C17.1, J3.2, R3.1, U3.6 (DVDD), U3.26 (IOVDD)
/IoT Sensor Node HPFE/FE_3V3A: C15.1, C17.2, R2.2, U3.30 (AVDD), U3.41 (AVDD)
/IoT Sensor Node HPFE/FE_AD5941_CS: J3.6, U3.15 (CS*)
/IoT Sensor Node HPFE/FE_AIN0: J4.4, U3.39 (AIN0)
/IoT Sensor Node HPFE/FE_AIN1: J4.3, U3.38 (AIN1)
/IoT Sensor Node HPFE/FE_AIN2: J4.2, U3.37 (AIN2)
/IoT Sensor Node HPFE/FE_AIN3: J4.1, U3.36 (AIN3/BUF_VREF1V8)
/IoT Sensor Node HPFE/FE_AVDD_REG: C21.1, U3.5 (AVDD_REG)
/IoT Sensor Node HPFE/FE_DVDD_REG1V8: C24.1, U3.14 (DVDD_REG1V8)
/IoT Sensor Node HPFE/FE_MISO: J3.3, U3.18 (MISO)
/IoT Sensor Node HPFE/FE_MOSI: J3.4, U3.17 (MOSI)
/IoT Sensor Node HPFE/FE_SCLK: J3.5, U3.16 (SCLK)
/IoT Sensor Node HPFE/FE_VBIAS0: C22.1, U3.8 (VBIAS0)
/IoT Sensor Node HPFE/FE_VBIAS_CAP: C25.1, U3.31 (VBIAS_CAP)
/IoT Sensor Node HPFE/FE_VREF_1V82: C19.1, U3.43 (VREF_1V82)
/IoT Sensor Node HPFE/FE_VREF_2V5: C20.1, U3.4 (VREF_2V5)
/IoT Sensor Node HPFE/FE_VSS: C16.2, C18.1, C19.2, C20.2, C21.2, C22.2, C23.2, C24.2, C25.2, D2.1 (K), J3.1, SW1.2, U3.13 (DGND), U3.23 (DGND), U3.25 (DGND), U3.49 (EP)
/IoT Sensor Node HPFE/FE_VSSA: C15.2, C18.2, U3.29 (AGND), U3.42 (AGND), U3.44 (AGND_REF)
/IoT Sensor Node HPFE/FE_VZERO0: C23.1, U3.9 (VZERO0)
/IoT Sensor Node HPFE/RCAL0: R1.1, U3.32 (RCAL0)
/IoT Sensor Node HPFE/RCAL1: R1.2, U3.33 (RCAL1)
/IoT Sensor Node HPFE/RESET: R2.1, SW1.1, U3.22 (RESET*)
unnamed: D2.2 (A), R3.2

Notes on the sheet:
AD5941
HPFE 3.3V Decouple
HPFE 3.3VA Decouple
1.82V and 2.5V
Analog Planes
DVDD 1.8V and AVDD
Vzero0 and Vbias
Vbias_cap
RCAL
Power + Data Connector
Signal Connector
Status LED

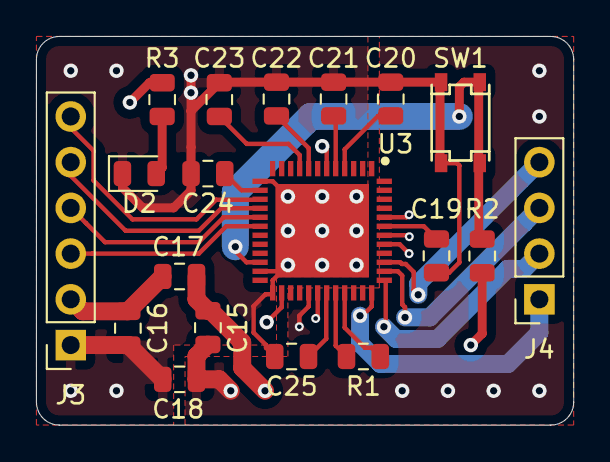
[picture p39: board kicad/daughter/IoT Sensor Node.kicad_pcb from above]

Board: 4 copper layers, 29.8 x 21.6 mm, 19 parts (0 on the bottom side), 23 nets.
