amantunes/KNoT/(commit log)

2021-01-19 Gerbers Added
2021-01-19 Added KiCad Files
    [IoT Sensor Node Connectors.sch, IoT Sensor Node HPFE.sch, IoT Sensor Node Mux.sch, IoT Sensor Node Power.sch, IoT Sensor Node RF.sch, IoT Sensor Node.kicad_pcb, IoT Sensor Node.sch]
2021-01-19 Libraries Added
    [IoT Sensor Node Connectors.sch, IoT Sensor Node HPFE.sch, IoT Sensor Node Mux.sch, IoT Sensor Node Power.sch, IoT Sensor Node RF.sch]
2021-01-27 Added the results section
    [14b_ds_mst_14840_bg2_20k.csv, 14b_ds_mst_29681_bg1_20k.csv, 16b_ds_mst_11010_bg1_20k.csv, 16b_ds_mst_11010_bg1_20k_high.csv, 16b_ds_mst_5505_bg2_20k.csv, 18b_ds_mst_1238_bg2_10k.csv, 18b_ds_mst_2477_bg1_10k.csv, 18b_ds_mst_2477_bg1_10k_high.csv]
